young-0320/zynq-fir-decimation-ip/docs/log/48_professor_meeting_2026_07_29.md

# 48. 2026-07-29 교수님 미팅 정리 (5차)

- 작성일: 2026-07-22
- 미팅 예정일: 2026-07-29
- 목적: log38 §8 지시 4건의 완료 보고(전력 실측·ASIC 결과 중심), v1↔v2 교체 결정,
  최종 발표(8/7) 방향 확인.
- 참고 문서:
  - `docs/log/38_professor_meeting_2026_07_01.md` (§8 지시 원문)
  - `docs/log/46_power_measurement_hds242_decisions.md` §5 (전력 실측 결과)
  - `docs/log/47_asic_track_a_oasys_sweep_nitro_halt.md` (ASIC sweep·P&R 중단)
  - `docs/report/fir_n43/summary/power_board_vs_vivado.md` / `asic_vs_fpga.md`
  - `docs/report/presentation_outline.md` (발표 구성안 12장+백업)

---

## 0. 미팅 대본 / 말하기 순서

### 0-1. 시작 — 지시 4건 완료 보고

```text
지난 미팅에서 주신 지시 4건을 모두 완료했습니다.

1. ASIC 워크플로우: 학교 서버 Oasys로 v1/v2 합성 sweep을 완결했습니다.
   P&R은 서버 툴 내부 버그로 중단됐는데, 원인과 재개 절차를 문서화해 두었습니다.
2. CPU 벤치마크 PNG: CPU 스펙과 측정 방법론을 차트에 기입 완료했습니다.
3. 전력 실측: 대여해 주신 HDS242로 보드 전력을 실측했고,
   Vivado 추정과 비교분석까지 마쳤습니다. 장비는 오늘 반납드리겠습니다.
4. 통합: 위 결과를 모두 v1.0 문서에 보조 지표로 통합했습니다.

오늘은 전력 실측과 ASIC 결과 두 가지를 보고드리고,
v1/v2 중 어느 쪽을 대표 산출물로 할지 확인받고 싶습니다.
```

### 0-2. 전력 실측 결과 제시

```text
측정은 보드 5V 전원 입력에 멀티미터를 직렬로 넣어 전류를 재고,
세 가지 상태의 차분으로 변수를 분리했습니다.

  S0 (FPGA 미구성 baseline):  1.72 W
  S1 (부팅 완료, FIR idle):   2.21 W
  S2 (mode 1-1 실행 중):      2.18 W

핵심 결과 세 가지입니다.

첫째, S1 − S0 = 0.49 W가 FPGA 구성 + 145MHz 클럭 + 앱 + DDR 활성의 몫입니다.

둘째, S2가 S1과 같습니다. FIR 연산이 83µs 만에 끝나기 때문에
1~2초 데모 주기에서 평균 전력에 잡히지 않는 것이고,
"연산이 그만큼 짧고 효율적이다"라는 것 자체가 측정 결과입니다.

셋째, Vivado 추정 1.705W와의 비교입니다. 실측 2.21W에서
USB-UART 칩 몫 0.22W를 실측으로 분리하고 레귤레이터 효율 85~90%를 감안하면
1.7W 안팎으로, 추정과 정합하는 범위입니다.
```

### 0-3. ASIC 결과 제시

```text
Oasys로 v1과 v2를 같은 제약으로 20000ps부터 6000ps까지 sweep했습니다.

결과가 흥미로운데, FPGA에서 26% 차이가 났던 v1/v2가
표준셀 합성에서는 전 구간 동률입니다. 둘 다 166.7MHz 이상 통과합니다.

원인까지 확인했습니다. v1의 병목이었던 누산+라운딩 병합 경로를
FPGA CARRY4는 8.664ns에 처리했지만, 표준셀 합성기는
가산기를 재구조화해서 5.719ns에 흡수합니다.
즉 v2 분할의 이득은 FPGA의 고정 캐리 체인이라는 물리 구조에 종속된
타겟 특화 최적화라는 걸 데이터로 증명한 셈입니다.

P&R은 Nitro placer가 내부 오류(SDA101)로 두 번 같은 지점에서 죽어서
툴 버그로 결론 내리고 중단했습니다. 비교 결론은 합성 결과로 완결이라
P&R이 더해줄 것은 "post-route에서도 유지된다" 한 줄뿐이었습니다.
절차는 재개 가능하게 보존해 두었습니다.
```

### 0-4. 세게 물으실 때 짧은 답변

**mode를 돌려도 전력이 안 늘면 측정이 잘못된 것 아닌가?**

```text
아닙니다. 사전에 예상하고 문서화해 둔 결과입니다.
8192샘플 처리가 83µs라, 1~2초 데모 주기에서 duty가 0.01% 수준입니다.
멀티미터는 수백 ms 평균을 표시하므로 원리적으로 안 잡힙니다.
순간 전류 파형을 보려면 스코프+션트 구성이 필요한데,
비파괴 원칙과 범위 관리 차원에서 이번엔 제외했습니다.
```

**PL만의 전력은 분리 못 하나?**

```text
Zybo Z7-20은 코어 레일에 전류 측정 헤더가 없어서
rail 직접 측정은 트레이스 컷이 필요한 파괴적 방법입니다.
대여·실습 보드라 배제했고, 대신 상태 차분으로
"FPGA 구성+클럭이 더해지는 몫 0.49W"까지는 비파괴로 분리했습니다.
Vivado 계층 분해로는 코어 자체는 0.015W 수준입니다.
```

**250nm ASIC이 28nm FPGA보다 빠르다는 게 말이 되나?**

```text
FPGA의 로직은 LUT와 고정 배선을 거치는 오버헤드가 커서,
같은 RTL이라도 표준셀 직접 구현이 유리한 경우가 많습니다.
특히 이 설계의 병목인 캐리 체인은 FPGA에서 재구조화가 안 되는 반면
표준셀 합성은 자유롭게 최적화합니다. 그 차이가 그대로 나타난 것입니다.
```

**ASIC 전력(1.3W)이 FPGA 추정(1.7W)과 비슷한데 비교 의미는?**

```text
두 수치는 성격이 달라 절대 비교하지 않았습니다.
FPGA 1.7W는 PS7 포함 전체 칩, 코어만은 0.015W이고,
ASIC 1.3W는 250nm 공정에서 toggle-rate 가정으로 추정한 코어 값입니다.
비교 목적은 절대치가 아니라 v1↔v2의 상대 비교와 타겟 종속성 확인입니다.
```

### 0-5. v1↔v2 결정 여쭤보기

```text
마지막으로 v1과 v2 중 대표 산출물 결정을 확인받고 싶습니다.

저는 v2를 대표로 하는 게 맞다고 생각합니다.
근거는, Fmax가 116 대 146으로 26% 높고, 자원은 동급이며,
전력 차이는 6mW로 보드에서 검출 불가능한 수준이고,
145MHz 보드 기능 동작과 전력 실측까지 v2 빌드로 완료했기 때문입니다.
ASIC에서 동률이라는 결과도, v2로 가서 손해 볼 것이 없다는 뜻입니다.

v1은 버리는 게 아니라 "타겟 특화 최적화의 비교 사례"로
발표와 문서에 계속 사용합니다.
```

### 0-6. 마무리 — 남은 일정

```text
결과보고서는 7/23에 제출했고, 이제 남은 것은 8/7 최종 발표입니다.
발표는 12장 구성으로 초안을 잡아 두었고,
설계-검증-실측-보조지표 순으로 구성했습니다.
발표 분량이나 강조점에 대해 조언 주시면 반영하겠습니다.

공개 자산화(GitHub/Velog/YouTube)는 발표 전까지 순차 완료 예정입니다.
```

---

## 1. 보고 수치 요약

### 전력 실측 (Track B, 2026-07-22)

| 상태 | 조건 | I_med | V | P |
| --- | --- | ---: | ---: | ---: |
| S0 | PL 미구성 baseline | 0.340 A | 5.047 V | 1.72 W |
| S1 | boot 완료, FIR idle | 0.443 A | 4.988 V | 2.21 W |
| S2 | `mode 1-1` 반복 실행 | 0.435 A | 5.008 V | 2.18 W |

- S1−S0 = 0.49W (PL 구성+클럭+앱+DDR), S2−S1 ≈ 0 (µs burst 미검출 — 예측 부합)
- USB-UART 0.22W 실측 분리, Vivado 1.705W와 정합 범위
- 부가: reset 없는 `mode 1-1` 반복 실행 정상 (§5.1 한계 "정상 경로 해소" 보드 확정)

### ASIC (Track A, log 47)

| | FPGA (28nm) | ASIC (250nm 합성) |
| --- | ---: | ---: |
| v1 Fmax | 116 MHz | ≥ 166.7 MHz |
| v2 Fmax | 146 MHz | ≥ 166.7 MHz |
| v1↔v2 격차 | +26% | 노이즈 수준 (동률) |

- 같은 병목 경로: CARRY4 8.664ns vs 표준셀 5.719ns → 분할 이득은 FPGA 물리 구조 종속
- Nitro P&R: placer 내부 버그(SDA101) 2회 재현으로 중단, 절차 보존

## 2. 지난 지시(log38 §8) 반영 현황

| 지시 | 상태 | 산출물 |
| --- | :--: | --- |
| §8-1 ASIC 워크플로우 | ✅ | log 47, `summary/asic_vs_fpga.md` (합성 완결, P&R 중단 문서화) |
| §8-2 CPU PNG 측정조건 명시 | ✅ | `cpu_vs_fpga_timing_window.png` 스펙·방법론 기입 |
| §8-3 전력 실측 | ✅ | log 46 §5, `summary/power_board_vs_vivado.md` |
| §8-4.5 v1.0 문서 통합 | ✅ | sweep_summary 교차참조, 보고서·발표 초안 반영 (D2) |

## 3. v1↔v2 결정 논의 자료

| 판단 축 | v1 | v2 | 비고 |
| --- | --- | --- | --- |
| FPGA Fmax | 116 MHz | **146 MHz (+26%)** | clk_wiz 정밀 스윕 (log 40) |
| 자원 | 동급 | 동급 (LUT 1792/FF 2113/DSP 16) | 파이프 FF 소폭 차이뿐 |
| Vivado 전력 | 1.699 W | 1.705 W | Δ6mW — 보드 검출 불가 (log 46 §2) |
| 보드 검증 | 115MHz 기능 동작 ✅ | 145MHz 기능 동작 + 전력 실측 ✅ | 실측 이력은 v2가 더 두터움 |
| ASIC | 동률 | 동률 | 교체해도 ASIC 관점 손실 없음 |

**제안: v2를 대표 산출물로 채택.** v1은 폐기가 아니라 "타겟 특화 최적화 비교 사례"
(발표 슬라이드 9·11의 주인공)로 유지.

## 4. 실제 미팅 피드백 (2026-07-29)

별도의 수정 지시나 방향 변경 없이 종료되었다. 준비한 발표자료(PPT)를 검토하시고
잘 준비했다는 평을 주신 것이 피드백의 전부다.

정리:

- 추가 지시사항 없음. §0 대본으로 준비한 전력·ASIC 보고와 예상 질문 답변은 실제로
  깊게 파고드는 질의 없이 지나갔다.
- v1↔v2 대표 산출물은 §3의 제안대로 **v2**로 확정. 이후 발표자료·배포 이미지
  (`release/v2_145mhz/BOOT.bin`)·전력 실측 기준이 모두 v2@145MHz로 통일되어 있다.
- HDS242 반납 완료.
- 남은 일정은 8/7 최종 발표뿐이며, 공개 자산화(GitHub·Velog)는 자체 일정으로 진행.

즉 이 미팅은 방향을 바꾸는 자리가 아니라 앞선 4차 미팅 지시사항(보조지표 4건)의
이행을 확인하고 발표 준비 상태를 점검하는 자리였다.
