young-0320/zynq-fir-decimation-ip/asic/oasys/results/sweep_report.md

# ASIC(Oasys) Synthesis Frequency Sweep — FIR v1/v2

- 대상: `fir_n43`(v1) / `fir_n43_v2`(v2) — 순수 FIR core, 단일 파일 (`rtl/transposed_form/n43/`)
- 합성 도구: Oasys-RTL, 공정: Tanner Generic 250nm (`TANNER_TT_2P50V_25C.lib`, TT/2.5V/25°C)
- 방법론: `asic/oasys/clk.sdc` 하나를 v1/v2가 공유 — 같은 period로 페어 실행한 결과만 비교표에 올린다
- 목적: workflow_v23 Track A(§8-1) ASIC 보조 지표 + "v1의 critical path 병목(FPGA CARRY4
  캐리 체인)은 FPGA 전용"이라는 가설 실증
- 작성일: 2026-07-21 (sweep 진행에 따라 갱신)

## 1. Sweep 결과 — v1 (`fir_n43`)

margin(%) = WNS / period × 100.

| period(ps) | freq(MHz) | WNS(ps) | margin(%) | cells | area(sq um) | total_power(mW) | result |
| ---: | ---: | ---: | ---: | ---: | ---: | ---: | --- |
| 20000 | 50.0 | +1757.5 | 8.8 | 16918 | 1115360 | 689.0 | pass |
| 15000 | 66.7 | +946.6 | 6.3 | 25193 | 1333340 | 794.0 | pass |
| 12000 | 83.3 | +1133.5 | 9.4 | 25387 | 1337280 | 843.0 | pass |
| 10000 | 100.0 | +199.0 | 2.0 | 25994 | 1354345 | 944.4 | pass |
| 9000 | 111.1 | +100.2 | 1.1 | 26018 | 1353851 | 987.3 | pass |
| 8000 | 125.0 | +52.0 | 0.7 | 27359 | 1390189 | 1115.0 | pass |
| 6000 | 166.7 | +0.3 | 0.0 | 28615 | 1421329 | 1330.9 | pass |

## 2. Sweep 결과 — v2 (`fir_n43_v2`)

| period(ps) | freq(MHz) | WNS(ps) | margin(%) | cells | area(sq um) | total_power(mW) | result |
| ---: | ---: | ---: | ---: | ---: | ---: | ---: | --- |
| 20000 | 50.0 | +2039.1 | 10.2 | 16799 | 1122327 | 682.3 | pass |
| 15000 | 66.7 | +4680.8 | 31.2 | 25118 | 1344378 | 781.1 | pass |
| 12000 | 83.3 | +1680.8 | 14.0 | 25118 | 1344378 | 847.5 | pass |
| 10000 | 100.0 | +129.2 | 1.3 | 25689 | 1360577 | 954.4 | pass |
| 9000 | 111.1 | +526.3 | 5.8 | 25718 | 1360446 | 995.6 | pass |
| 8000 | 125.0 | +72.3 | 0.9 | 27002 | 1394726 | 1119.4 | pass |
| 6000 | 166.7 | +13.5 | 0.2 | 27506 | 1405196 | 1342.4 | pass |

(주1) power는 `report_power -total_only`로 추출 — 한 줄에 internal/switching/leakage/total
분해가 모두 포함된다(PF-263). 기본 `report_power`는 계층 없는 코어 직접 합성이라 인스턴스
4096개에서 잘리며 total이 생략되므로 쓰지 않는다. 이 power는 워크로드 VCD가 아닌 기본
toggle-rate 가정 기반 추정치.

## 3. v1 vs v2 비교 (동일 period 페어)

| period(ps) | v1 WNS | v2 WNS | ΔWNS(v2−v1) | v1 area | v2 area | Δarea | v1 P(mW) | v2 P(mW) | ΔP |
| ---: | ---: | ---: | ---: | ---: | ---: | ---: | ---: | ---: | ---: |
| 20000 | +1757.5 | +2039.1 | +281.6 | 1115360 | 1122327 | +0.6% | 689.0 | 682.3 | −1.0% |
| 15000 | +946.6 | +4680.8 | +3734.2 | 1333340 | 1344378 | +0.8% | 794.0 | 781.1 | −1.6% |
| 12000 | +1133.5 | +1680.8 | +547.3 | 1337280 | 1344378 | +0.5% | 843.0 | 847.5 | +0.5% |
| 10000 | +199.0 | +129.2 | −69.8 | 1354345 | 1360577 | +0.5% | 944.4 | 954.4 | +1.1% |
| 9000 | +100.2 | +526.3 | +426.1 | 1353851 | 1360446 | +0.5% | 987.3 | 995.6 | +0.8% |
| 8000 | +52.0 | +72.3 | +20.3 | 1390189 | 1394726 | +0.3% | 1115.0 | 1119.4 | +0.4% |
| 6000 | +0.3 | +13.5 | +13.2 | 1421329 | 1405196 | −1.1% | 1330.9 | 1342.4 | +0.9% |

### Critical path 구조 (핵심 관찰)

| | startpoint | endpoint | logic depth | 경로 구조 |
| --- | --- | --- | ---: | --- |
| v1 @20000ps | `prod_reg_reg[10][1]/Q` | `z_reg[32][47]/DATA` | 85 | Stage2 가산기 (prod_reg + z → z_reg), AOI22/BUFI4 반복 = ripple-carry 체인 |
| v2 @20000ps | `prod_reg_reg[8][1]/Q` | `z_reg[34][47]/DATA` | 84 | 동일 구조 |
| v1 @15000ps | `prod_reg_reg[10][1]/Q` | `round_reg_reg[32]/DATA` | 50 | 누산+라운딩 병합 경로 — v2가 분할한 바로 그 경로 (탭 가산기는 재구조화로 빨라져 depth 85→50, 대신 이 병합 경로가 병목으로 부상) |
| v2 @15000ps | `in_sample[3]` (input port) | `prod_reg_reg[23][26]/DATA` | 48 | 입력→곱셈 경로 (미제약 입력, rtDefaultClock). worst가 이 경로라는 것 = 내부 reg-to-reg 전부 slack ≥ +4680.8 |
| v1 @12000ps | `prod_reg_reg[10][1]/Q` | `round_reg_reg[31]/DATA` | 40 | 여전히 누산+라운딩 병합 경로. 합성기가 더 조여서 depth 50→40, slack은 15000ps 때보다 오히려 개선(+946.6→+1133.5) |
| v2 @12000ps | `in_sample[3]` | `prod_reg_reg[23][26]/DATA` | 48 | 15000ps와 동일 netlist (cells/area/arrival 10038.9ps 완전 동일 — 여유가 있어 재합성 불필요). 한계는 입력→곱셈 경로 ~10039ps |
| v1 @10000ps | `prod_reg_reg[0][6]/Q` | `round_reg_reg[30]/DATA` | 40 | 병합 경로가 arrival 9520.7ps까지 압축 — 12000ps 때 "하한"으로 보였던 곱셈 경로(10039ps)보다도 빨라짐 (곱셈 경로도 재구조화됨) |
| v2 @10000ps | `z_reg[0][47]/Q` | `round_reg_reg[32]/DATA` | 33 | v2 자신의 라운딩 스테이지(Stage3, z[0]→round_reg)가 병목으로 등장, arrival 9590.5ps — v1의 병합 경로와 사실상 같은 수준 |
| v1 @9000ps | `prod_reg_reg[0][5]/Q` | `round_reg_reg[29]/DATA` | 39 | 병합 경로 8619.5ps까지 추가 압축 (−9.5%) — 아직 한계 아님 |
| v2 @9000ps | `in_sample[1]` | `prod_reg_reg[13][24]/DATA` | 38 | 라운딩 스테이지가 재구조화로 물러나고 입력→곱셈 경로가 다시 worst (10038.9→8193.4ps, −18%) |
| v1 @8000ps | `prod_reg_reg[0][4]/Q` | `round_reg_reg[31]/DATA` | 38 | 병합 경로 7667.7ps (−11%) — 여전히 압축 여력 발견 |
| v2 @8000ps | `z_reg[0][47]/Q` | `round_reg_reg[32]/DATA` | 24 | 라운딩 스테이지 복귀, 7647.4ps — v1과 20ps 차이 |
| v1 @6000ps | `z_reg[1][8]/Q` | `round_reg_reg[31]/DATA` | 31 | FPGA v1 critical path와 시작·끝이 동일한 경로(z_reg[1]→round_reg, log 39의 z_reg[1][2]→round_reg_reg[45]) — 단 도달치 5718.7ps로 slack +0.3, 턱걸이 PASS |
| v2 @6000ps | `in_sample[4]` | `prod_reg_reg[24][25]/DATA` | 26 | 입력→곱셈 경로 5706.2ps |

## 4. 해석 (sweep 진행하며 갱신)

**20000ps (느슨한 제약) — 잠정 "v1 ≈ v2"로 보였던 구간:**

- 두 버전 모두 critical path가 순수 탭 누산 경로(prod_reg[k]+z[k+1]→z_reg[k])의
  ripple-carry 체인(depth 85). 느슨한 제약에서 합성기가 면적 최소인 ripple 매핑을
  선택해 add 1회 자체가 지배적이었고, v2가 분할한 누산+라운딩 병합 경로는 한계를
  정하는 경로가 아니었다 → WNS 차이 1.4%p로 "분할은 FPGA 전용" 가설과 일치해 보임.

**15000ps (타이트한 제약) — 반전, 분할이 ASIC에서도 유효:**

- 제약을 조이자 합성기가 탭 가산기를 더 빠른 구조로 재합성(depth 85→50, 그 대가로
  cells +49%/area +19%). 그러자 v1의 병목이 누산+라운딩 병합 경로
  (prod_reg→round_reg)로 이동 — FPGA에서와 같은, v2가 분할한 바로 그 경로다.
- v2는 그 경로가 없어 WNS +4680.8 vs v1 +946.6 — slack 5배 차이. v2의 worst 경로는
  미제약 입력 경로(in_sample→prod_reg)라서 내부 reg-to-reg 한계는 이보다도 위에 있다.
- 잠정 Fmax 추정(1/(period−WNS)): v1 ≈ 71MHz, v2 ≥ 97MHz — 파이프라인 분할이
  ASIC에서도 유효하다는 방향. "분할은 FPGA 전용 최적화" 가설은 느슨한 제약에서만
  성립하는 착시였고, 도구가 가산기를 최적화하고 나면 타겟 불문 "add+round 병합"이
  구조적 병목이라는 쪽으로 수렴 중. 확정은 pass/fail 경계(이분탐색)로.
- 전력·면적은 여전히 v1 ≈ v2 (ΔP −1.6%, Δarea +0.8%): 분할의 비용이 사실상 0이라는
  점도 v2의 손을 들어줌. leakage는 total의 0.001% — 250nm 예상대로 무시 가능,
  "ASIC total ≈ dynamic" 취급 유효.

**12000ps — 격차는 좁혀지나 순서는 유지, 공통 하한(곱셈 경로) 등장:**

- v1: 합성기가 라운딩 병합 경로를 더 조여(depth 50→40, cells +194) slack이 15000ps보다
  오히려 개선(+1133.5). v2: 15000ps netlist 그대로 재사용(여유 충분) — 한계는 입력→곱셈
  경로 arrival ~10039ps로 고정.
- 잠정 Fmax 추정: v1 ≈ 92MHz, v2 ≈ 97MHz — 15000ps에서 5배였던 slack 격차가 좁혀짐.
  ~~곱셈 경로 ~10ns가 공통 하한~~ → 10000ps에서 곱셈 경로도 재구조화되어 하한이
  아니었음이 확인됨(아래).

**10000ps — 수렴: 둘 다 PASS(100MHz), v1이 근소 우위로 역전:**

- v1 +199.0 vs v2 +129.2 (ΔWNS −69.8ps, period의 0.7%) — 12000ps까지의 v2 우위가
  사라지고 사실상 동률(오히려 v1이 근소 우위).
- 메커니즘: 합성기를 한계까지 밀자 v1의 누산+라운딩 병합 경로가 9520.7ps까지 압축됨
  (multi-operand add를 carry-save/compound 구조로 재조직 — 표준셀에서는 add 2회
  병합이 add 1회 + 압축단 수준의 비용). 한편 v2는 자신의 라운딩 스테이지(z[0]→
  round_reg, 48-bit 라운딩 가산)가 새 병목으로 등장, 9590.5ps — 결국 양쪽 다
  "라운딩이 포함된 최종 가산" 하나가 한계를 정하는 동일 구도로 수렴.
- 이것이 FPGA와의 구조적 차이: FPGA CARRY4는 고정 캐리 체인이라 add 2회 병합을
  재구조화할 수 없어 v1의 병합 경로가 통째로 두 체인 값을 냈고(그래서 분할이 26%
  이득), ASIC 표준셀 합성은 그 병합을 흡수해버린다 — "분할의 이득은 FPGA 물리
  구조에 종속" 가설이 pass/fail 경계 근처에서 결국 성립하는 방향.
- 잠정 Fmax 추정: v1 ≈ 102MHz, v2 ≈ 101MHz. ~~8000ps는 확실한 FAIL~~ →
  9000ps 결과로 반증됨(아래) — 합성기의 스텝당 개선(~10%)이 아직 포화되지 않았다.

**9000ps — 둘 다 PASS(111MHz), v2 재역전, 순위는 런마다 요동:**

- v1 +100.2(margin 1.1%) vs v2 +526.3(5.8%) — 10000ps에서 뒤졌던 v2가 다시 앞섬.
  v2는 라운딩 스테이지가 재구조화로 물러나고 입력→곱셈 경로가 worst로 복귀
  (8193.4ps, 12000ps 대비 −18%). v1 병합 경로도 8619.5ps로 −9.5% 추가 압축.
- 순위가 런마다 뒤집히는 것 자체가 결론의 일부: 두 버전의 한계 경로 도달치가 수 %
  이내로 붙어 있어, 순서는 합성 휴리스틱의 런별 편차에 좌우된다. FPGA의 26% 차이
  같은 구조적 격차는 ASIC에 없다.
- 잠정 Fmax 추정: v1 ≈ 112MHz, v2 ≈ 118MHz. 다음: 8000ps 페어 — v1은 −10.4% 추가
  압축이 필요해 경계 직전(직전 스텝 개선폭 −9.5%와 거의 같음), v2는 −5.8%면 됨.
  여기서 v1 FAIL / v2 PASS로 갈리면 그 지점이 최종 판별점.

**8000ps — 판별점에서도 안 갈림: 둘 다 PASS(125MHz), Δ 20ps로 완전 수렴:**

- v1 +52.0 vs v2 +72.3 — 차이 20.3ps는 period의 0.25%. v1 병합 경로 7667.7ps,
  v2 라운딩 스테이지 7647.4ps로 도달치까지 사실상 동일. "v1 FAIL/v2 PASS로 갈린다"는
  시나리오는 실현되지 않음 — v1의 병합 경로는 8000ps에서도 압축 여력을 찾아냄.
- margin 추이(2.0→1.1→0.7%)와 면적 증가(cells 25994→27359)를 보면 툴이 "겨우 맞추기"
  를 반복하며 한계에 접근 중. 잠정 Fmax: v1 ≈ 125.8MHz, v2 ≈ 126.1MHz — 격차 0.3%.
- 결론 방향 사실상 확정: ASIC(현대적 datapath 합성)에서는 v1/v2 구조적 격차가 없다.
  v2 분할의 이득은 FPGA CARRY4 고정 체인에서만 발생하는 타겟 특화 효과.
- 다음: 아직 FAIL 앵커가 없음 — ~~7000ps~~ → 6000ps로 직행하기로 결정.

**6000ps — 여전히 둘 다 PASS(166.7MHz, v1은 slack +0.3ps 턱걸이). sweep 중단 결정:**

- −25% 압축 요구도 툴이 맞춰냄: v1 5718.7ps(slack +0.3), v2 5706.2ps(+13.5). Δslack
  13.2ps — 여전히 노이즈 수준 동률. 250nm ASIC이 28nm FPGA v2의 146MHz를 넘는
  166.7MHz에 도달했다는 것도 부수 확인.
- v1의 critical path가 FPGA v1과 시작·끝이 동일한 경로(z_reg[1]→round_reg)로 회귀 —
  같은 경로를 FPGA CARRY4는 8.66ns(120MHz fail, log 39), 250nm 표준셀 재구조화는
  5.72ns에 처리. "툴이 병합을 흡수한다"의 가장 직접적인 대비 증거.
- 방법론적 교훈(중단 사유): margin이 매 지점 0으로 수렴하는 건 한계 신호가 아니라
  제약 구동 합성의 본성이다 — 툴은 목표를 주면 면적을 태워 "겨우 맞추기"를
  반복하므로(cells 25994→28615), pass/fail 경계 탐색은 진짜 물리 한계가 나올 때까지
  런당 수 시간짜리 시도를 계속 요구한다. 절대 Fmax 확정은 Track A 목적(보조 지표 +
  v1/v2 비교)에 불필요하므로 여기서 중단, "양쪽 모두 ≥166.7MHz 확인(한계 미탐색),
  전 구간 격차 노이즈 수준"을 최종 기록으로 채택.

**최종 결론 (sweep 종료):**

- 20000→6000ps 6개 페어 전 구간에서 v1/v2 격차는 최대 수 %·순위 요동 — ASIC(현대적
  datapath 합성)에서 v1/v2 구조적 격차 없음. v2 분할의 26% Fmax 이득은 FPGA CARRY4
  고정 캐리 체인에서만 발생하는 타겟 특화 효과로 확정.
- 면적·전력도 전 구간 Δ 1% 안팎 동률. 주파수에 따라 면적 +27%(1.12M→1.42M),
  전력 689→1331mW로 증가 — 제약을 조일수록 툴이 면적/전력을 태워 타이밍을 사는
  전형적 trade-off (GEMM sweep과 동일 패턴).

## 5. FPGA 대비

작성 완료 — `docs/report/fir_n43/summary/asic_vs_fpga.md` (핵심 표 + 비교 한계 명시).

## 6. 남은 작업 / 이슈

- [x] ~~power total 재추출~~ — 20000ps 페어 `-total_only`로 재추출 완료. `-total_only`
      한 줄에 internal/switching/leakage 분해까지 포함되므로(PF-263) 이후 sweep도 이
      명령만 쓰면 됨 (`-all` grep 불필요).
- [x] ~~sweep~~ — 6페어(20000→6000ps) 완료, 전 지점 pass, §4 최종 결론으로 종료.
- [x] ~~FPGA 대비~~ — §5 참조.
- [x] ~~Nitro P&R (10000ps v1)~~ — 중단 (2026-07-21). 시도 기록: ① datapath 블럭
      36개가 고정 객체로 칩 밖에 생성됨 — 미배치 시 routing 실패, `place_macros`는
      "movable macro 없음"(PLC1020)으로 거부 → 수동 배치 필요(GEMM 수업 방식과 동일).
      ② 수동 배치 후 `run_place_timing`이 placer 내부 assertion 크래시
      (`SDA101: grCapFrac <= 1`, densityboxcontrol.cpp) — 칩 1.4mm(util 70%)→1.6mm
      (util 53%) 확대·재배치 후에도 동일 지점에서 재현. 2020.2 툴 내부 버그로 판단,
      사용자 측 회피 불가로 결론. 판정 근거 4가지(assertion 성격, 파라미터 무관 재현,
      GEMM 대조군, 회피 수단 소진)와 에러 원문은 `asic/nitro/error_records.md`.
      비교 결론은 합성(Oasys) 결과로 완결이므로 P&R은 범위에서 제외 —
      절차·스크립트(`asic/nitro/tcl/`)는 재개 가능 상태로 보존.

## Raw 리포트 경로

```text
asic/oasys/results/v1/v1_<period>ps_{synth.v,timing.rpt,area.rpt,power.rpt}
asic/oasys/results/v2/v2_<period>ps_{synth.v,timing.rpt,area.rpt,power.rpt}
```
