young-0320/zynq-fir-decimation-ip/docs/workflow/workflow_v24.md

# workflow_v24 — 마무리·공개 체크리스트 (최종)

- 작성일: 2026-07-22
- Purpose: 기술 작업(workflow_v23까지 전부 완료) 이후 남은 **제출·발표·공개 자산화**
  작업을 기한 순 체크리스트로 관리한다. 이 문서가 마지막 워크플로우다.
- 성격: 실행 계획/준비물 (결과·의사결정은 해당 log에 기록 — log 48 §4, 이후 필요 시 log 49)
- 선행: `workflow_v23.md` (Track A/B/C/D ✅), `docs/log/48` (5차 미팅 자료)
- 갱신: 2026-08-16 — §7 발표 수행 완료, §6 YouTube는 제작하지 않기로 확정(취소).
  §1~§5는 이전 갱신(2026-08-06)대로 완료. 남은 것은 §8 종료 처리뿐이다.

---

## 0. 타임라인 요약

| 기한 | 항목 | 섹션 |
| --- | --- | --- |
| **7/23 (목)** | 결과보고서 제출 | §1 |
| **7/29 (화)** | 5차 지도미팅 + HDS242 반납 + v1↔v2 결정 | §2 |
| ~8/6 | 발표자료 완성 + 리허설, 데모 준비 완료 | §3, §7 |
| **8/7 (목)**  | 최종 발표 | §7 |
| ~8/7 | GitHub·Velog 공개 자산화 완료 (YouTube는 취소) | §4~§6  |

---

## 1. 결과보고서 제출 (기한: 7/23 목) ✅ 완료 (2026-07-23 제출)

- [X] Ⅰ. 도전결과 및 성과 삽입 — 실측 완료 버전으로 교체
- [X] Ⅵ 총평: "초안 작성해보았습니다" 문구 삭제
- [X] Ⅵ 총평: "두 가지임"으로 수정 (첫째·둘째 구성과 정합)
- [X] Ⅱ 요약문 절감/초과 서술 모순 수정
- [X] Ⅱ 표 아래 예비비 공용 각주 추가
- [X] Ⅲ 중복 잔여 문장 삭제
- [X] Ⅲ 4-2 제목 → "시연 시각화 강화 지도"
- [X] Ⅲ 이메일 5/13 주제 → "피드백 반영·구매 상담"
- [X] 표지 지도교수 전화번호 확인 (031-201-3811)
- [X] 서식 확인
- [X] 교수님 Ⅵ 총평 검토·서명(인) — 2026-07-22자
- [X] 최종 PDF 변환 → 제출
- [X] 문서화 변경분 git 커밋

## 2. 5차 지도미팅 (7/29 화) — 진행 완료

- [X] `docs/log/48` §0 대본 숙지
- [X] **HDS242 반납**
- [X] **v1↔v2 대표 산출물 결정** — v2 채택 (발표자료·배포 이미지 모두 v2@145 기준)
- [X] 발표 분량·강조점 조언 받기
- [X] 미팅 결과를 log 48 §4에 기록 (2026-08-06) — 추가 지시 없이 발표 준비 상태 점검으로
  종료. v2 확정, HDS242 반납 완료

## 3. 데모 준비 (발표 시연용, ~8/6) ✅ 완료

- [X] **v2@145 BOOT SD 준비** (배포본은 `release/v2_145mhz/BOOT.bin`로도 추적 중)
- [X] 예비 SD 1장
- [X] 데모 노트북(Windows) 환경 점검
- [X] 전원 구성 확정
- [X] 데모 리허설
- [X] 실패 대비: FFT plot PNG 사전 캡처본을 백업 슬라이드에 포함

## 4. GitHub 정리 (~8/7, 에이전트 초안 지원 가능)

공개 전 문서 톤 정리는 **계층화 전략**으로 (전면 재작성 안 함 — 2026-07-22 확정):

- Tier 1 (관문 문서만 톤 정리): README + `summary/` 4종(scenario1_1/1_2,
  asic_vs_fpga, power_board_vs_vivado) — 이모지·과한 볼드·메타 표현 제거, 수치 불변
- Tier 2 (원본 보존 + 프레이밍): `docs/log/`·`docs/workflow/`는 가공하지 않고,
  `docs/log/README.md`에 "AI 협업 워크플로우로 작성된 의사결정 로그 원본, 사후 가공
  없이 보존" 안내문 한 장 추가
- Tier 3 (본인 목소리): Velog 연재는 에이전트 초안 후 **본인 퇴고 필수**

- [X] Tier 1 톤 정리 — summary 4종 + sweep_summary/_v2 + sweep_report + build_artifacts (2026-07-22)
- [X] Tier 2 — `docs/log/README.md`·`docs/workflow/README.md` 프레이밍 안내문 (2026-07-22)
- [X] README 재작성(소개·결과·차별점 중심) + `docs/getting_started.md` 분리 (2026-07-22).
  헤드라인 수치 5개는 배치 원칙의 예외로 README에 허용(사용자 확정)
- [X] 재현 절차 점검 (2026-07-23 전수조사 C) — 시뮬 경로는 성립: pytest 163개 PASS,
  벡터 삭제 후 문서 명령만으로 비트 단위 동일 재생성, `run_all`/`run_bug` 전부 PASS.
  발견된 결함은 아래 "전수조사 후속" 항목으로 이관
- [X] 민감 정보 스캔 (2026-07-22) — 학번·전화번호 텍스트 마스킹 완료. hwp·장학 md의
  잔여분과 히스토리 퍼지는 보류(사용자 판단: 민감도 낮음, 시간 나면 처리)
  → 2026-07-23 재스캔 결과 반영: asic tcl 학번 경로·author 이메일·교수 전화번호는
  **그대로 두기로 확정**(사용자 결정). 시크릿·10MB 초과 추적 파일 없음
- [X] 라이선스 파일 — 루트 LICENSE(MIT, 본인 명의) 존재 확인 (2026-07-22)
- [X] repo public 전환 → **링크 확보** (2026-08-06) —
  https://github.com/young-0320/zynq-fir-decimation-ip

### 전수조사 후속 (2026-07-23 감사 결과, public 전환 전 처리)

- [X] 🔴 **장학·제출 서류 삭제** (2026-08-06) — `docs/경희꿈도전장학 활동계획서_한영웅.pdf`,
  `docs/팀명_결과보고서.hwp`, 초안 md 2종(`final_report_draft.md`,
  `scholarship_report_section1_and_fixes.md`), `presentation_outline.md` 모두 레포에서
  제외. git 히스토리 퍼지는 하지 않음(민감도 낮음 — 2026-07-23 판단 유지)
- [X] 🔴 **fresh clone `make run_all` 실패 해소 (2026-07-23)** — README 수정 대신
  Makefile 자동 생성으로 해결(사용자 선택): `run_all`/`run_legacy_n5`가 벡터 부재 시
  기존 Python 스크립트 2종을 자동 실행(있으면 불변). 벡터 삭제 후 재검증 —
  자동 생성 → 전 TB PASS, 재생성 벡터 비트 동일. README Quick Start는 수정 불필요
- [X] README 개선 (2026-07-23) — 한/영 병기 전문 재작성: 이미지 3종(BD SVG·scenario1_1
  FFT·CPU 차트, 한글 본문에만 삽입/영어는 상단 그림 참조), Requirements, 근거 링크
  불릿화, Repository Map에 `boards/`·`release/` 추가+`build/` 각주, License(MIT) 섹션
- [X] **BOOT.bin 정식 승격 (2026-07-23)** — `release/v2_145mhz/BOOT.bin`(기본 권장)·
  `release/v1_115mhz/BOOT.bin` git 추적 + `release/README.md` 사용법. `.gitignore`
  `!release/*/BOOT.bin` negation. 클론 직후 빌드 없이 보드 데모 가능.
  경위: `docs/log/50`
- [X] (참고) n5 벡터 재생성 절차 (2026-07-23) — 문서화 대신 Makefile 자동 생성으로
  해소 (`run_legacy_n5`가 n5 벡터 부재 시 자동 생성, 위 항목과 동일 패턴)
- [ ] (참고) axis TB 2종의 `$readmemh` "Too many words [0:4095]" 경고 (4117워드 vs 4096
  배열) — 판정 무해하나 첫 사용자 불안 요소

## 5. Velog 연재 ✅ 완료 (2026-08-06, 요구 3편 이상 → 5편 게시)

실제 연재는 후보 주제 나열이 아니라 **시간순 서사**로 재구성했다. 트러블슈팅 3편
(2·3·4편)을 중심에 두되, 앞에 bring-up(1편)을, 뒤에 결산(5편)을 붙여 프로젝트 전체가
하나의 흐름으로 읽히게 했다. ASIC 타겟 종속성은 독립 편 대신 5편의 핵심 절로 넣었다.

- [X] 1편: Block Design부터 비트스트림·XSA까지
- [X] 2편: DDR byte[3] 오염 — JTAG ELF 로딩에 걸린 16일 (재료: log 21~27)
- [X] 3편: 끝나지 않는 MM2S — AXI DMA 1바이트 초과 (재료: log 31/32)
- [X] 4편: 동작하는 회로의 버그 4개 (재료: log 41~44)
- [X] 5편: 숫자로 쓰는 결산 — Fmax 스윕·CPU 대비·전력 실측·ASIC 교차 검증
  (재료: log 37/39/40/46/47/49 + summary 4종)
- [X] 링크 확보 → README 한/영 "개발 연재 (Velog)" 섹션에 5편 전부 반영

5편 작성 중 확인된 사항 (원고에 반영, 근거는 아래 문서):

- N=43 선정 근거를 저지대역 worst-case 기준으로 재서술 (log 07 — 39/41탭은 25MHz
  한 점만 보면 통과처럼 보이나 전 구간 worst-case에서 미달)
- 시나리오 1-2의 45MHz 실측 −64.5dB는 필터 성능이 아니라 **측정계의 관측 하한**
  (계수 응답 |H(45MHz)| = 77.2dB, float64 재현에서도 동일 수준 → 양자화 아님)
- 25MHz만 −6.02dB 정규화 오프셋이 상쇄됨 (출력 Nyquist bin은 크기가 2배로 잡힘)
- CPU 221.0µs는 대표값이 아니라 최종 차트 생성 라운드의 값이며 관찰 구간(170~300µs)의
  높은 쪽 — 배속을 2.0~3.5배 구간으로 병기 (log 49)

## 6. YouTube 데모 영상 — ❌ 제작하지 않음 (2026-08-16 확정)

2026-08-06 시점에는 "발표 후로 연기"였으나, 발표를 마친 뒤 **제작하지 않는 것으로
확정**했다. 발표 당일 라이브 데모가 성립했고, 시연 근거는 백업 캡처본(§3)과 레포의
FFT plot·측정 리포트로 이미 남아 있어 영상이 추가로 확보하는 것이 없다.

공개 자산은 **GitHub·Velog 2종**으로 확정한다 (발표 마지막 슬라이드도 동일).

아래는 취소된 계획으로, 기록 목적으로만 남긴다.

- ~~촬영 구성안: 보드·결선 소개(30초) → SD boot + `READY FIR`(30초) →
  `mode 1-1` 실행 + FFT plot(1분) → 입·출력 스펙트럼 비교 해설(1분) — 총 3분 내외~~
- ~~촬영 (화면 녹화 + 보드 실물 컷, 폰 거치 고정)~~
- ~~자막/설명란: 프로젝트 요약 + GitHub 링크~~
- ~~업로드 → 링크 확보 → README "개발 연재" 섹션에 추가~~

## 7. 최종 발표자료 + 발표 (8/7 목) ✅ 완료

- [X] 슬라이드 제작 — 본문 7장 + 백업 3장 구성으로 확정 (outline 12장안 대비 압축)
- [X] 그림 자산 수집: BD 블록도, FFT plot, `cpu_vs_fpga_timing.png`, 전력 측정표, ASIC 표
- [X] 백업 슬라이드 (전력 실측 · 구현 수치 요약 · 보드 검증 수치) + Q&A 답변 숙지
- [X] 5차 미팅 조언 반영
- [X] 리허설
- [X] 마지막 슬라이드에 공개 자산 링크 2종 (GitHub/Velog)
- [X] 발표 당일 준비물: 노트북, 보드, SD 2장, 어댑터, USB 케이블, 발표자료 USB/클라우드 백업
- [X] **8/7 발표 수행**

## 8. 종료 처리

- [X] 발표 후 피드백·결과 기록 — **해당 없음, log 51 생성 안 함**. 질의응답이나 피드백
  없이 발표만 진행된 자리였다. 기록할 내용이 없어 이 줄로 대체한다
- [X] 대여물 반납 완료 확인 (HDS242 — §2, 7/29 미팅에서 반납)
- [X] CLAUDE.md 갱신 — 2026-08-06 공개 자산화 반영 후, 2026-08-16 발표 완료·YouTube
  취소로 완결 표시까지 반영
- [X] 최종 커밋 (2026-08-16, 발표 완료·YouTube 취소 문서 현행화)
- [X] ~~`v1.0` tag~~ — **달지 않기로 확정** (2026-08-16). 태그 없이 종료한다
- [X] ~~YouTube 영상 (§6)~~ — 제작하지 않기로 확정 (2026-08-16), README 반영 불필요

---

## 현재 상태 (2026-08-16)

| 절 | 상태 |
| --- | --- |
| §1 결과보고서 | ✅ 7/23 제출 |
| §2 5차 미팅 | ✅ 7/29, 결과 log 48 §4 기록 완료 |
| §3 데모 준비 | ✅ |
| §4 GitHub | ✅ public 전환 완료 — https://github.com/young-0320/zynq-fir-decimation-ip |
| §5 Velog | ✅ 5편 게시 (요구 3편 이상) |
| §6 YouTube | ❌ 제작하지 않음 (2026-08-16 확정) |
| §7 발표 | ✅ 8/7 발표 수행 완료 |
| §8 종료 | ✅ 완료 — log 51·`v1.0` tag 모두 미생성으로 확정 |

**프로젝트 종료.** 계획된 작업은 전부 끝났다.

유일한 미결은 §4의 참고 항목 하나 — axis TB 2종의 `$readmemh` "Too many words"
경고다. 판정에는 무해하고(전 TB PASS) 고치지 않은 채 종료한다. 처리하려면 TB의
배열 크기를 4096 → 4117로 맞추면 되나, 이는 검증 결과를 바꾸지 않는 미화 작업이다.

---

## 에이전트 지원 가능 항목 요약

| 항목 | 에이전트가 할 수 있는 것 |
| --- | --- |
| §1 보고서 | 수정 문안은 전부 준비됨 (대화 기록) — 반영은 사용자(한글 파일) |
| §4 GitHub | README·재현 절차 초안 작성, 민감 정보 스캔 |
| §5 Velog | 각 편 초안 작성 (log 재료 기반) |
| §7 발표자료 | 슬라이드별 문안·표·그림 스펙 작성, Q&A 답변 정리 |
| §8 종료 | log 49 정리, CLAUDE.md 갱신, 커밋 메시지 |
