young-0320/zynq-fir-decimation-ip/docs/asset/Fig 2. AXI stream signals.png

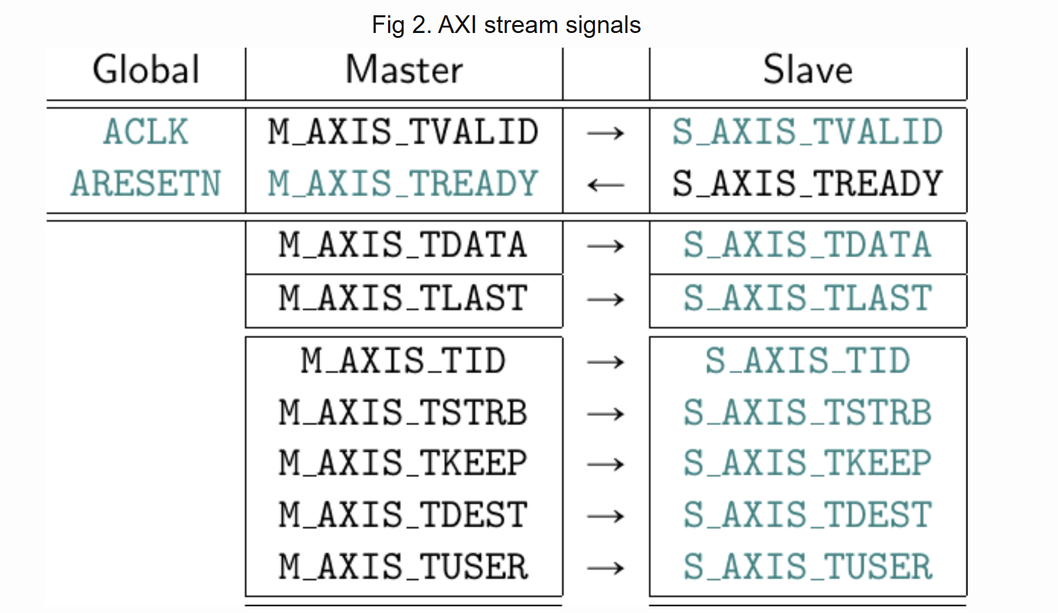
docs/asset/Fig 2. AXI stream signals.png
