young-0320/zynq-fir-decimation-ip/docs/asset/kaiser window.png

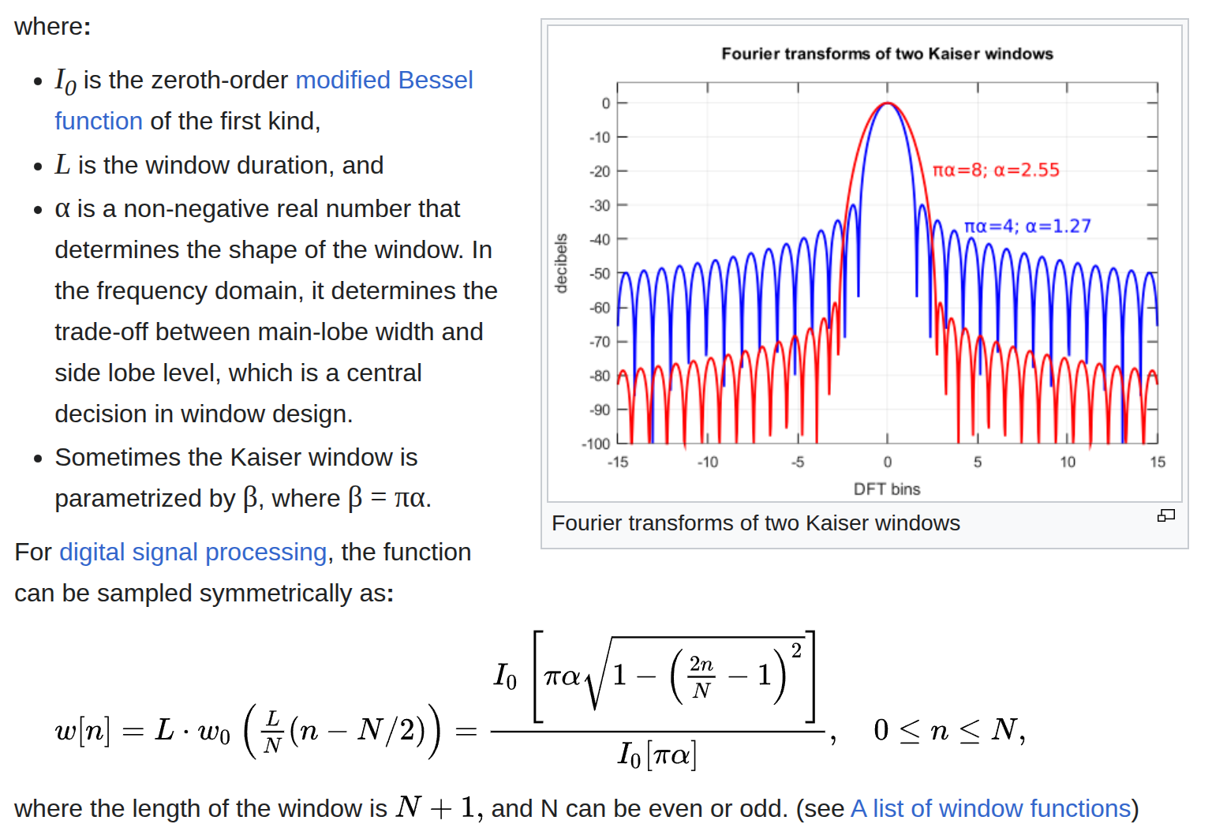
docs/asset/kaiser window.png
