young-0320/zynq-fir-decimation-ip/docs/report/fir_n43/plot/scenario1_2_fft.png

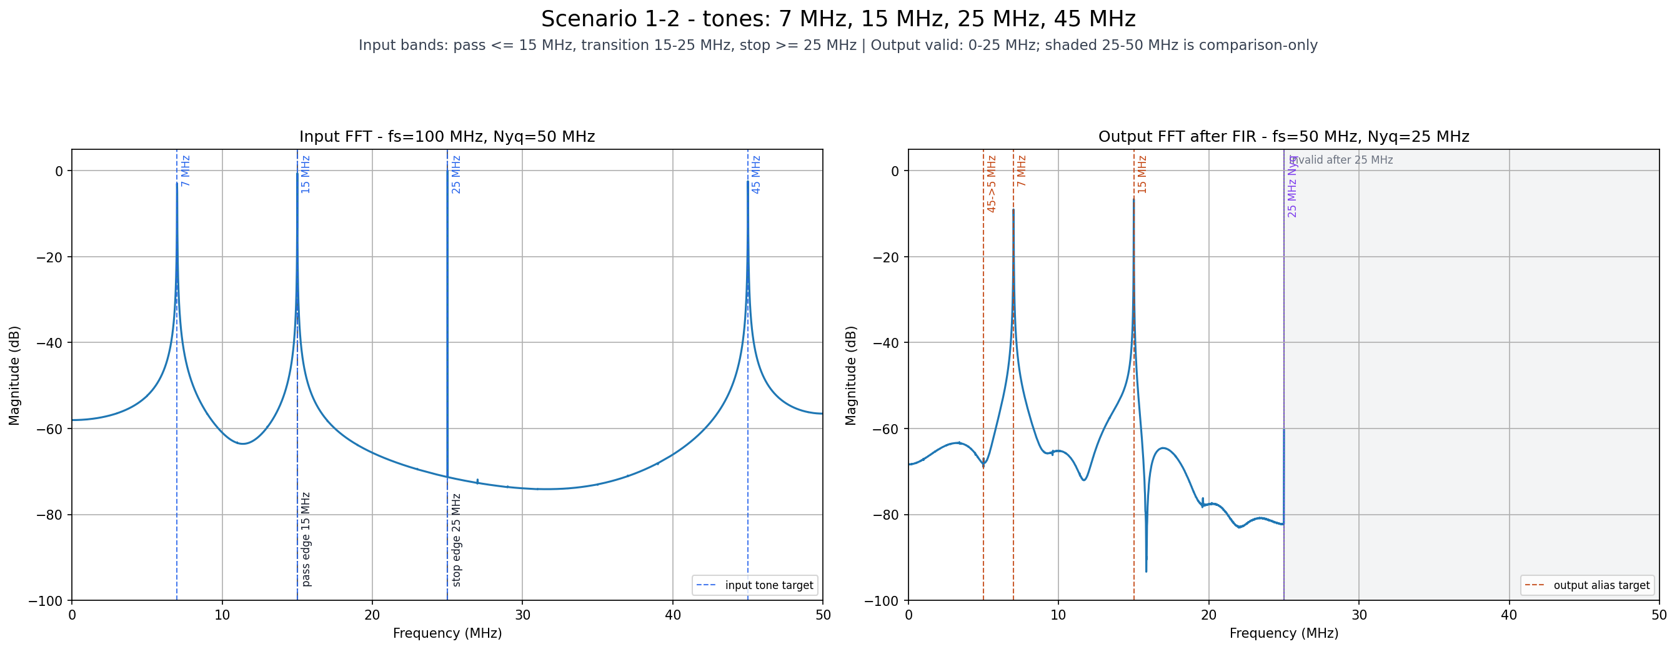
docs/report/fir_n43/plot/scenario1_2_fft.png
