young-0320/zynq-fir-decimation-ip/rtl/transposed_form/n43/fir_n43_v2.v

`timescale 1ns / 1ps
`default_nettype none

// FIR Transposed Form N=43 — v2 (120MHz 크리티컬 패스 보완, workflow_v21 참고)
//
// 설계 기준: docs/log/14_transposed_form_rtl_decisions.md
// v1(fir_n43.v) 대비 변경점: docs/workflow/workflow_v21.md
//
// v1은 Stage 2에서 누산과 round를 같은 사이클에 묶어 계산했다
// (round_reg <= round_q2_30_to_q1_15(prod_reg[0] + z[1])).
// 이 경로가 120MHz 타이밍 위반의 크리티컬 패스였다
// (vivado/reports/sweep_summary.md 참고, CARRY4x19 체인).
//
// v2는 누산(Stage 2)과 round(Stage 3)를 분리해 한 사이클 더 쓴다.
// round는 재계산 없이 레지스터에 저장된 z[0]을 그대로 읽는다.
//
// 파이프라인 4단계:
//   Stage 1: in_valid=1 → h[k]*in_sample → prod_reg[k]  (k=0..42 병렬)
//   Stage 2: prod_reg[k] + z[k+1] → z[k]  (누산만)
//   Stage 3: round(z[0]) → round_reg
//   Stage 4: saturate(round_reg) → out_sample
//
// Latency: 4 cycles (accepted input 기준, v1 대비 +1 cycle)
// z[k]   : signed 48-bit (Q2.30)
// 반올림 : ties-away-from-zero, 출력 1회
// 포화   : 출력 1회 clip(-32768, 32767)
// z[42]  : prod_reg[42] only (z[43] 없음, B안)
// 출력값은 v1과 100% 동일 (계산 순서만 재배치, 로직 자체는 변경 없음)

module fir_n43_v2 (
    input  wire               clk,
    input  wire               rst,
    input  wire               in_valid,
    input  wire signed [15:0] in_sample,
    output reg                out_valid,
    output reg signed  [15:0] out_sample
);

  // -----------------------------------------------------------------------
  // 계수 (Q1.15, ties-away-from-zero 반올림)
  // -----------------------------------------------------------------------
  localparam signed [15:0] COEFF_0 = 16'sd10;
  localparam signed [15:0] COEFF_1 = 16'sd0;
  localparam signed [15:0] COEFF_2 = -16'sd33;
  localparam signed [15:0] COEFF_3 = -16'sd32;
  localparam signed [15:0] COEFF_4 = 16'sd47;
  localparam signed [15:0] COEFF_5 = 16'sd107;
  localparam signed [15:0] COEFF_6 = 16'sd0;
  localparam signed [15:0] COEFF_7 = -16'sd197;
  localparam signed [15:0] COEFF_8 = -16'sd159;
  localparam signed [15:0] COEFF_9 = 16'sd206;
  localparam signed [15:0] COEFF_10 = 16'sd425;
  localparam signed [15:0] COEFF_11 = 16'sd0;
  localparam signed [15:0] COEFF_12 = -16'sd674;
  localparam signed [15:0] COEFF_13 = -16'sd522;
  localparam signed [15:0] COEFF_14 = 16'sd654;
  localparam signed [15:0] COEFF_15 = 16'sd1336;
  localparam signed [15:0] COEFF_16 = 16'sd0;
  localparam signed [15:0] COEFF_17 = -16'sd2258;
  localparam signed [15:0] COEFF_18 = -16'sd1939;
  localparam signed [15:0] COEFF_19 = 16'sd2995;
  localparam signed [15:0] COEFF_20 = 16'sd9864;
  localparam signed [15:0] COEFF_21 = 16'sd13109;
  localparam signed [15:0] COEFF_22 = 16'sd9864;
  localparam signed [15:0] COEFF_23 = 16'sd2995;
  localparam signed [15:0] COEFF_24 = -16'sd1939;
  localparam signed [15:0] COEFF_25 = -16'sd2258;
  localparam signed [15:0] COEFF_26 = 16'sd0;
  localparam signed [15:0] COEFF_27 = 16'sd1336;
  localparam signed [15:0] COEFF_28 = 16'sd654;
  localparam signed [15:0] COEFF_29 = -16'sd522;
  localparam signed [15:0] COEFF_30 = -16'sd674;
  localparam signed [15:0] COEFF_31 = 16'sd0;
  localparam signed [15:0] COEFF_32 = 16'sd425;
  localparam signed [15:0] COEFF_33 = 16'sd206;
  localparam signed [15:0] COEFF_34 = -16'sd159;
  localparam signed [15:0] COEFF_35 = -16'sd197;
  localparam signed [15:0] COEFF_36 = 16'sd0;
  localparam signed [15:0] COEFF_37 = 16'sd107;
  localparam signed [15:0] COEFF_38 = 16'sd47;
  localparam signed [15:0] COEFF_39 = -16'sd32;
  localparam signed [15:0] COEFF_40 = -16'sd33;
  localparam signed [15:0] COEFF_41 = 16'sd0;
  localparam signed [15:0] COEFF_42 = 16'sd10;

  // 반올림 상수: Q2.30 → Q1.15, bias = 2^(15-1) = 16384
  localparam signed [47:0] ROUND_BIAS = 48'sd16384;
  localparam signed [47:0] Q15_MAX = 48'sd32767;
  localparam signed [47:0] Q15_MIN = -48'sd32768;

  // -----------------------------------------------------------------------
  // Stage 1 레지스터
  // -----------------------------------------------------------------------
  reg signed [47:0] prod_reg[0:42];
  reg prod_valid;

  // -----------------------------------------------------------------------
  // Stage 2 레지스터 (누산)
  // -----------------------------------------------------------------------
  reg signed [47:0] z[0:42];  // delay register, Q2.30
  reg acc_valid;

  // -----------------------------------------------------------------------
  // Stage 3 레지스터 (round)
  // -----------------------------------------------------------------------
  reg signed [47:0] round_reg;
  reg round_valid;

  // -----------------------------------------------------------------------
  // 조합 논리: 16x16 → 32bit 곱셈, sign-extend → 48bit
  // -----------------------------------------------------------------------
  wire signed [31:0] prod_comb[0:42];
  wire signed [47:0] prod_wide[0:42];

  assign prod_comb[0]  = COEFF_0 * in_sample;
  assign prod_comb[1]  = COEFF_1 * in_sample;
  assign prod_comb[2]  = COEFF_2 * in_sample;
  assign prod_comb[3]  = COEFF_3 * in_sample;
  assign prod_comb[4]  = COEFF_4 * in_sample;
  assign prod_comb[5]  = COEFF_5 * in_sample;
  assign prod_comb[6]  = COEFF_6 * in_sample;
  assign prod_comb[7]  = COEFF_7 * in_sample;
  assign prod_comb[8]  = COEFF_8 * in_sample;
  assign prod_comb[9]  = COEFF_9 * in_sample;
  assign prod_comb[10] = COEFF_10 * in_sample;
  assign prod_comb[11] = COEFF_11 * in_sample;
  assign prod_comb[12] = COEFF_12 * in_sample;
  assign prod_comb[13] = COEFF_13 * in_sample;
  assign prod_comb[14] = COEFF_14 * in_sample;
  assign prod_comb[15] = COEFF_15 * in_sample;
  assign prod_comb[16] = COEFF_16 * in_sample;
  assign prod_comb[17] = COEFF_17 * in_sample;
  assign prod_comb[18] = COEFF_18 * in_sample;
  assign prod_comb[19] = COEFF_19 * in_sample;
  assign prod_comb[20] = COEFF_20 * in_sample;
  assign prod_comb[21] = COEFF_21 * in_sample;
  assign prod_comb[22] = COEFF_22 * in_sample;
  assign prod_comb[23] = COEFF_23 * in_sample;
  assign prod_comb[24] = COEFF_24 * in_sample;
  assign prod_comb[25] = COEFF_25 * in_sample;
  assign prod_comb[26] = COEFF_26 * in_sample;
  assign prod_comb[27] = COEFF_27 * in_sample;
  assign prod_comb[28] = COEFF_28 * in_sample;
  assign prod_comb[29] = COEFF_29 * in_sample;
  assign prod_comb[30] = COEFF_30 * in_sample;
  assign prod_comb[31] = COEFF_31 * in_sample;
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
  assign prod_wide[39] = {{16{prod_comb[39][31]}}, prod_comb[39]};
  assign prod_wide[40] = {{16{prod_comb[40][31]}}, prod_comb[40]};
  assign prod_wide[41] = {{16{prod_comb[41][31]}}, prod_comb[41]};
  assign prod_wide[42] = {{16{prod_comb[42][31]}}, prod_comb[42]};

  // -----------------------------------------------------------------------
  // 반올림/포화 함수 (v1과 동일)
  // -----------------------------------------------------------------------
  function automatic signed [47:0] round_q2_30_to_q1_15;
    input signed [47:0] value;
    reg signed [47:0] magnitude;
    reg signed [47:0] rounded_magnitude;
    begin
      magnitude = (value < 0) ? -value : value;
      rounded_magnitude = (magnitude + ROUND_BIAS) >>> 15;
      round_q2_30_to_q1_15 = (value < 0) ? -rounded_magnitude : rounded_magnitude;
    end
  endfunction

  function automatic signed [15:0] saturate_to_q1_15;
    input signed [47:0] value;
    begin
      if (value > Q15_MAX) saturate_to_q1_15 = 16'sd32767;
      else if (value < Q15_MIN) saturate_to_q1_15 = -16'sd32768;
      else saturate_to_q1_15 = value[15:0];
    end
  endfunction

  // -----------------------------------------------------------------------
  // Stage 1: 곱셈 → prod_reg
  // -----------------------------------------------------------------------
  integer i;
  always @(posedge clk or posedge rst) begin
    if (rst) begin
      prod_valid <= 1'b0;
      for (i = 0; i <= 42; i = i + 1) prod_reg[i] <= 48'sd0;
    end else begin
      if (in_valid) begin
        prod_reg[0]  <= prod_wide[0];
        prod_reg[1]  <= prod_wide[1];
        prod_reg[2]  <= prod_wide[2];
        prod_reg[3]  <= prod_wide[3];
        prod_reg[4]  <= prod_wide[4];
        prod_reg[5]  <= prod_wide[5];
        prod_reg[6]  <= prod_wide[6];
        prod_reg[7]  <= prod_wide[7];
        prod_reg[8]  <= prod_wide[8];
        prod_reg[9]  <= prod_wide[9];
        prod_reg[10] <= prod_wide[10];
        prod_reg[11] <= prod_wide[11];
        prod_reg[12] <= prod_wide[12];
        prod_reg[13] <= prod_wide[13];
        prod_reg[14] <= prod_wide[14];
        prod_reg[15] <= prod_wide[15];
        prod_reg[16] <= prod_wide[16];
        prod_reg[17] <= prod_wide[17];
        prod_reg[18] <= prod_wide[18];
        prod_reg[19] <= prod_wide[19];
        prod_reg[20] <= prod_wide[20];
        prod_reg[21] <= prod_wide[21];
        prod_reg[22] <= prod_wide[22];
        prod_reg[23] <= prod_wide[23];
        prod_reg[24] <= prod_wide[24];
        prod_reg[25] <= prod_wide[25];
        prod_reg[26] <= prod_wide[26];
        prod_reg[27] <= prod_wide[27];
        prod_reg[28] <= prod_wide[28];
        prod_reg[29] <= prod_wide[29];
        prod_reg[30] <= prod_wide[30];
        prod_reg[31] <= prod_wide[31];
        prod_reg[32] <= prod_wide[32];
        prod_reg[33] <= prod_wide[33];
        prod_reg[34] <= prod_wide[34];
        prod_reg[35] <= prod_wide[35];
        prod_reg[36] <= prod_wide[36];
        prod_reg[37] <= prod_wide[37];
        prod_reg[38] <= prod_wide[38];
        prod_reg[39] <= prod_wide[39];
        prod_reg[40] <= prod_wide[40];
        prod_reg[41] <= prod_wide[41];
        prod_reg[42] <= prod_wide[42];
        prod_valid   <= 1'b1;
      end else begin
        prod_valid <= 1'b0;
      end
    end
  end

  // -----------------------------------------------------------------------
  // Stage 2: 누산 → z[k] 갱신
  // -----------------------------------------------------------------------
  always @(posedge clk or posedge rst) begin
    if (rst) begin
      acc_valid <= 1'b0;
      for (i = 0; i <= 42; i = i + 1) z[i] <= 48'sd0;
    end else begin
      if (prod_valid) begin
        z[0] <= prod_reg[0] + z[1];
        z[1] <= prod_reg[1] + z[2];
        z[2] <= prod_reg[2] + z[3];
        z[3] <= prod_reg[3] + z[4];
        z[4] <= prod_reg[4] + z[5];
        z[5] <= prod_reg[5] + z[6];
        z[6] <= prod_reg[6] + z[7];
        z[7] <= prod_reg[7] + z[8];
        z[8] <= prod_reg[8] + z[9];
        z[9] <= prod_reg[9] + z[10];
        z[10] <= prod_reg[10] + z[11];
        z[11] <= prod_reg[11] + z[12];
        z[12] <= prod_reg[12] + z[13];
        z[13] <= prod_reg[13] + z[14];
        z[14] <= prod_reg[14] + z[15];
        z[15] <= prod_reg[15] + z[16];
        z[16] <= prod_reg[16] + z[17];
        z[17] <= prod_reg[17] + z[18];
        z[18] <= prod_reg[18] + z[19];
        z[19] <= prod_reg[19] + z[20];
        z[20] <= prod_reg[20] + z[21];
        z[21] <= prod_reg[21] + z[22];
        z[22] <= prod_reg[22] + z[23];
        z[23] <= prod_reg[23] + z[24];
        z[24] <= prod_reg[24] + z[25];
        z[25] <= prod_reg[25] + z[26];
        z[26] <= prod_reg[26] + z[27];
        z[27] <= prod_reg[27] + z[28];
        z[28] <= prod_reg[28] + z[29];
        z[29] <= prod_reg[29] + z[30];
        z[30] <= prod_reg[30] + z[31];
        z[31] <= prod_reg[31] + z[32];
        z[32] <= prod_reg[32] + z[33];
        z[33] <= prod_reg[33] + z[34];
        z[34] <= prod_reg[34] + z[35];
        z[35] <= prod_reg[35] + z[36];
        z[36] <= prod_reg[36] + z[37];
        z[37] <= prod_reg[37] + z[38];
        z[38] <= prod_reg[38] + z[39];
        z[39] <= prod_reg[39] + z[40];
        z[40] <= prod_reg[40] + z[41];
        z[41] <= prod_reg[41] + z[42];
        z[42] <= prod_reg[42];
        acc_valid <= 1'b1;
      end else begin
        acc_valid <= 1'b0;
      end
    end
  end

  // -----------------------------------------------------------------------
  // Stage 3: round(z[0]) → round_reg
  // -----------------------------------------------------------------------
  always @(posedge clk or posedge rst) begin
    if (rst) begin
      round_valid <= 1'b0;
      round_reg   <= 48'sd0;
    end else begin
      if (acc_valid) begin
        round_reg <= round_q2_30_to_q1_15(z[0]);
        round_valid <= 1'b1;
      end else begin
        round_valid <= 1'b0;
      end
    end
  end

  // -----------------------------------------------------------------------
  // Stage 4: 포화 → 출력
  // -----------------------------------------------------------------------
  always @(posedge clk or posedge rst) begin
    if (rst) begin
      out_valid  <= 1'b0;
      out_sample <= 16'sd0;
    end else begin
      if (round_valid) begin
        out_sample <= saturate_to_q1_15(round_reg);
        out_valid  <= 1'b1;
      end else begin
        out_valid <= 1'b0;
      end
    end
  end

endmodule

`default_nettype wire
