young-0320/zynq-fir-decimation-ip/(commit log)

2026-03-09 feat: add ideal fir-decimator chain and baseline path
2026-03-11 Add fixed-model scaffolding and shift workflow stages
2026-03-18 feat: add ideal-vs-fixed comparison flow
    [06_ideal_vs_fixed_compare_n5_metrics.csv]
2026-03-18 Add coefficient stopband spec check flow
2026-03-31 Update bring-up docs and add RTL placeholder
    [06_ideal_vs_fixed_compare_n5_metrics.csv]
2026-04-12 rtl: add bringup reset conditioner
    [reset_conditioner.v]
2026-04-12 docs: clarify bringup reset and auto-run flow
    [reset_conditioner.v]
2026-04-12 rtl: fix vivado memory init file lookup
    [top_zybo_bringup_n5.v]
2026-04-30 docs: add project direction change and transposed form design logs (#12–14)
    - 12: advisor feedback 반영 후 프로젝트 방향 전환 기록
    (N=43 Transposed Form 직접 진입, 100MHz Clocking Wizard, AXI 실시간 시연 목표)
    - 13: Transposed Form Q1.15 골든 모델 연산 정책 확정
    (wide 48-bit acc, ties-away-from-zero, 최종 출력 1회 반올림/포화)
    - 14: N=43 Transposed Form RTL 설계 결정 확정
    (1 sample/cycle 병렬, 2단계 파이프라인, FIR latency 2 cycles, localparam 하드코딩)
2026-04-30 docs: update workflow v7→v8 (golden model complete, RTL next)
2026-04-30 feat: add Q1.15 Transposed Form golden model
    - anti_alias_fir.py: 48-bit accumulator, ties-away-from-zero, final saturation only
    - fir_decimator_golden.py: FIR→Decimation chain wrapper
    - verified: Direct vs Transposed max diff = 0 LSB (bit-exact)
2026-05-03 feat(rtl): add fir_decimator_transposed_n43_top and tb, iverilog PASS
    fir_decimator_transposed_n43_top: fir_transposed_n43 + decimator_m2_phase0 연결 top.
    tb: expected_decim_q15.hex 4117 샘플 self-checking, PASS 확인.
2026-05-03 feat(vivado): add build TCL and update XDC for 100MHz timing closure
    zybo_n43.xdc: 100MHz 클럭 제약 추가 (IP 코어 타이밍 검증용, 보드 핀 제약은 AXI-Stream 단계에서).
    vivado/build_fir_transposed_n43.tcl: 프로젝트 생성 → synth → impl → timing report 자동화.
    CLAUDE.md: Step 2 완료, Step 3 시작으로 업데이트.
2026-05-03 fix(rtl): extend fir_transposed_n43 to 3-stage pipeline for timing closure
    2단계에서 WNS=-1.155ns 위반 → round_reg 스테이지 추가로 3단계 확장.
    Stage2: z[k] 업데이트 + round_reg 저장
    Stage3: saturate → out_sample
    결과: WNS=+0.278ns (100MHz 클로저), LUT=1827, DSP48=16.
    iverilog 두 TB 모두 PASS 재확인 (FIR 8234, decimator 4117 samples).
    [fir_transposed_n43.v]
2026-05-03 docs: add log 16 — Vivado timing closure for N=43 Transposed Form
    board_part 에러, WNS=-1.155ns 타이밍 위반, DSP48=0 오독 세 가지 트러블슈팅 기록.
    round_reg 스테이지 추가(3단계 확장)로 WNS=+0.278ns 클로저 달성한 과정 문서화.
2026-05-03 docs: update CLAUDE.md and log 16 style fixes
    CLAUDE.md: 3단계 파이프라인 다이어그램 반영, latency 수정(FIR 2→3, Top 3→4),
    로그 작성 규칙에 섹션 번호 형식(## 1) ) 추가.
    log 16: 섹션 번호 형식, --- 구분선, 결론 서술형, 메타데이터 위치 등 스타일 수정.
2026-05-03 fix(vivado): fix DSP48 filter and add utilization report to build TCL
    REF_NAME =~ DSP48* is the correct filter (PRIMITIVE_TYPE =~ DSP* always returns 0).
    Also removes board_part property (not installed on build machine) and adds
    report_utilization output alongside timing summary.
2026-05-03 docs: update hardware pipeline doc with demo scenarios 0/1/2
    Add scenario 0 (aliasing comparison without FIR) to explain why the
    system is necessary. Clarify scenario 1 (fixed signal) and scenario 2
    (interactive audience input) flow and role breakdown.
2026-05-03 docs: update CLAUDE.md — add demo scenarios and new doc file paths
    Add §5 demo scenarios (0 aliasing comparison / 1 basic / 2 interactive),
    add docs/study_roadmap.md and docs/하드웨어 파이프라인.md to directory
    structure section.
2026-05-04 fix: update decimator path, upgrade output buffer depth-2→depth-3
2026-05-04 chore: add decimator_m2_phase0 to transposed_form, fix CLAUDE.md formatting
    [decimator_m2_phase0.v]
2026-05-04 feat(step5): add AXI-Stream wrapper and TB for N=43 FIR decimator
    fir_decimator_transposed_n43_axis_top: depth-3 output buffer, TLAST_N=512,
    s_axis_tready=~valid2 stall. TB covers TREADY=1, backpressure 3:1, and
    aresetn recovery — all 3 scenarios PASS (4117 samples, bit-exact).
    [fir_decimator_transposed_n43_axis_top.v, tb_fir_decimator_transposed_n43_axis_top.v]
2026-05-04 refactor(step5-1): RTL 코드 스타일 통일 및 모듈 구조 README 추가
2026-05-04 test(step5-2): TB robustness 강화 — 전 계층 TB 재작성
2026-05-04 refactor(step5-1): 모듈 네이밍 정리 — transposed/top 중복 제거
    - transposed_form/ 하위 모듈에서 경로로 자명한 'transposed' 접미어 제거
    - board-level top이 없는 IP 코어이므로 모든 모듈에서 '_top' 제거
    - fir_transposed_n43 → fir_n43
    - fir_decimator_transposed_n43_top → fir_decimator_n43
    - fir_decimator_transposed_n43_axis_top → fir_decimator_n43_axis
2026-05-05 fix(axis): s_axis_tready = ~valid1으로 출력 버퍼 오버플로 수정
    ~valid2 기준으로 backpressure를 걸면 버퍼가 이미 full인 시점에서
    stall이 전파된다. valid2(registered) 기반 1-cycle 지연으로 샘플 1개가
    FIR에 누출되고, 2사이클 후 in-flight 출력이 도달할 때 버퍼가 여전히
    full이면 silently drop된다. TREADY 30% 조건에서 49% 확률 재현.
    ~valid1으로 변경해 valid2를 in-flight 출력의 완충 슬롯으로 확보.
    [fir_decimator_n43_axis.v]
2026-05-05 test: TB .v → .sv 재작성, scoreboard/watchdog/랜덤 버블 추가
    - NBA(<=) → blocking(=) + negedge 앵커 수정
    - int expected_q[$] scoreboard 큐로 순서 검증
    - watchdog timer 추가 (파이프라인 stall 감지)
    - drain loop timeout 추가
    - $signed() 캐스팅으로 push → 부호 불일치 수정
    - S2 랜덤 버블 주입, AXIS TB S3 reset recovery 추가
    - Makefile: .v → .sv TB 파일 참조 변경
2026-05-05 docs: step 5-2 로그 작성, CLAUDE.md 상태 업데이트
    log 18: 버퍼 오버플로 원인 분석 및 TB 재작성 내용 정리
    CLAUDE.md: Step 5-2 ✅ 완료, Step 6 현재 작업으로 전환
2026-05-05 test(axis): S2 백프레셔 시나리오에 TLAST 검증 추가
    check_mode 1→2: 랜덤 TREADY 30% 조건에서
    데이터 정합성뿐 아니라 TLAST 타이밍도 검증.
2026-05-05 docs: log 18 버그 원인 분석 설명 개선
    플립플롭 1-cycle 지연 개념을 더 쉽게 풀어 서술.
2026-05-06 feat(step7-8): bare-metal C + PC Python FFT 데모 스크립트 구현
    - sw/fir_decimator_demo.c: PS ARM 펌웨어 (DMA 제어, UART 송수신, 멀티톤 생성)
    - sw/fir_decimator_demo.py: PC FFT 시각화 (scenario 0/1/2, plt.ion() 실시간 갱신)
    - sw/test/test_fir_decimator_demo.py: 단위 테스트 25개 (happy path + edge case)
    - vitis/: Vitis 빌드 스크립트
    - vivado/bd_fir_dma.tcl: DMA Block Design TCL
    - docs/log/19-22: PS-PL DMA 설계, C 코드 설계, Vitis 빌드 절차, Python 설계 플랜
    - docs/데모 시나리오.md: 시나리오 0/1/2 정의
    - pyproject.toml: matplotlib, pyserial 의존성 추가, sw/test testpath 추가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
2026-05-06 docs: README 및 TCL 업데이트
2026-05-06 fix(vitis): C 소스 경로 ps/ → sw/ 수정, CLAUDE.md 업데이트
    vitis 빌드 스크립트가 존재하지 않는 ps/ 디렉토리를 참조하고 있어
    xsct 실행 시 즉시 실패하는 버그 수정.
2026-05-06 docs: workflow v10 업데이트, v11 보드 검증 가이드 작성
    Step 5~8 코드 완성 상태를 v10에 반영하고,
    보드 연결 후 Vitis 빌드 → UART 확인 → Python FFT 시각화
    순서를 v11에 정리.
2026-05-06 docs: CLAUDE.md 현재 단계 및 다음 절차 업데이트
    현재 위치를 Step 7로 수정하고 workflow_v11.md 참조와
    보드 검증 단계별 명령어 추가.
2026-05-06 docs: summary_design_decisions.md 최신화 (2026-03-09 → 2026-05-07)
    Step 5~8 완료에 따른 설계 결정 추가:
    - RTL 확정값 (3단계 파이프라인, 48-bit 누산기, symmetry 미사용)
    - AXI-Stream 래퍼 (aresetn, TLAST=512, depth-3 버퍼, TDATA=16bit)
    - PS-PL DMA 연동 (Module Reference, Simple DMA, HP0, bd_fir_dma.tcl)
    - bare-metal C + UART (N_IN/OUT, cache 정책, 패킷 마커)
    - PC Python FFT (mode 0/1/2, dB scale, x축 고정)
    - 미정 항목 전부 확정으로 정리
2026-05-06 docs: N=43 Transposed Form RTL spec 작성
    포트 계약, 3단계 파이프라인 latency, valid/reset 규칙,
    AXI-Stream 핸드셰이크, TB 검증 기준, 빌드 명령을 단일 문서로 정리.
2026-05-06 fix(rtl): fir_n43.v 파이프라인 주석 수정 (2단계→3단계, latency 2→3 cycles)
    타이밍 클로저 시 round_reg 삽입으로 3단계로 확장됐으나
    상단 주석이 갱신되지 않은 채 남아 있었음.
2026-05-06 feat(vivado): BD → 비트스트림 + XSA 자동화 스크립트 추가
    bd_fir_dma.tcl(BD 재생성)을 source하고 합성/구현/비트스트림/
    XSA 생성까지 한 번에 처리. XSA 경로는 vitis 빌드 스크립트와 일치.
2026-05-08 fix(vivado): UART1 PS7 설정 추가 + 빌드 경로 repo 내부로 수정
    bd_fir_dma.tcl:
    - PS7에 UART1 명시적 활성화 (MIO 48..49, 115200baud, IO PLL 100MHz)
    - 새 Vitis SDT 기반 BSP는 XSA에 명시된 주변장치만 포함하므로 필수
    - UART0 비활성화 (Zybo Z7-20 물리 핀 미연결)
    build_bd_fir_dma.tcl:
    - 빌드 경로 /mnt/workspace/ → $REPO_ROOT/build/vivado
    - XSA 출력 경로 → build/output/bd_fir_dma_wrapper.xsa
    - RTL 파일 경로 오류 수정: direct_form/ → transposed_form/
2026-05-08 fix(sw): UART_DEVICE_ID 수정 + Vitis 빌드 스크립트 Python으로 재작성
    fir_decimator_demo.c:
    - UART_DEVICE_ID: XPAR_XUARTPS_1_DEVICE_ID → 0
    - 새 SDT 기반 BSP는 UART1 단일 인스턴스를 canonical index 0으로 매핑
    build_fir_decimator_demo.py (신규, tcl 대체):
    - xsct TCL은 Vitis 2024.x에서 동작 불가 (--classic 제거됨)
    - vitis -s <script.py> Python API 방식으로 재작성
    - set_workspace → update_workspace, set_property → set_app_config
    - no_boot_bsp=True, generate_dtb=False (Lopper 오류 방지)
    - ELF을 build/output/으로 자동 복사
    build_fir_decimator_demo.tcl: 삭제 (deprecated)
    결과: build/output/fir_decimator_demo.elf 242KB 생성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
    [fir_decimator_demo.c]
2026-05-08 docs(log): Vitis ELF 빌드 트러블슈팅 기록 추가 (log 23)
    xsct → Python 전환 과정에서 발생한 7가지 문제 상세 기록:
    1. xsct PATH 문제 (xsct-trim/bin/ 경로 분리)
    2. xsct --classic 에러 (Vitis 2024.x deprecated)
    3. workspace 버전 불일치 (update_workspace로 전환)
    4. Lopper null 경로 (Vitis Embedded Development 미설치)
    5. Lopper pip install 실패 (AMD 설치 버그 → 수동 설치)
    6. xuartps.h 미포함 (SDT BSP는 명시적 UART 활성화 필요)
    7. XPAR_XUARTPS_1_DEVICE_ID 미정의 (canonical index 변경)
2026-05-08 docs(log): workflow_v11 Step 7 보드 검증 절차 업데이트
    - Step 7-A: xsct TCL → vitis -s Python 명령어 수정
    - Step 7-B: Vitis GUI → xsdb 커맨드라인 절차로 교체
    - 환경 설정: ~/.bashrc 등록 → 터미널 세션당 1회 수동 소싱 방식으로 변경
    - 트러블슈팅 표: xuartps.h, DEVICE_ID, Lopper 항목 추가
    - 경로 전체 /mnt/workspace/ → build/output/ 수정
2026-05-08 docs: README 사전 조건 상세화 + CLAUDE.md Step 7 완료 반영
    README.md:
    - 사전 조건을 4개 섹션으로 확장
    - Vitis Core vs Vitis Embedded Development 차이 명시
    - Lopper AMD 설치 버그 및 수동 설치 방법 추가
    - settings64.sh 소싱 필수 안내
    - 의존성 버전 표 + Ubuntu 설치 명령어
    - vivado 명령어에 -journal/-log 플래그 추가 (중간 산출물 repo 루트 오염 방지)
    - xsct → vitis -s 명령어 수정
    - 트러블슈팅 로그 링크 추가
    CLAUDE.md:
    - Step 7: 🔄 → ✅ ELF 생성 완료 (242KB)
    - 다음 절차: xsct → xsdb + vitis -s 명령어로 수정
    - Updated 날짜: 2026-05-08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
2026-05-08 chore: 마크다운 포맷 정리 + 불필요 파일 삭제
    - workflow_v9.md, 데모 시나리오.md: 테이블 정렬 및 공백 자동 포맷 적용
    - summary_design_decisions.md: 삭제 (내용이 CLAUDE.md와 중복, 관리 단일화)
    - .gitignore: PROJECT_CONTEXT.md 제외 항목 삭제 (파일 삭제에 따른 정리)
2026-05-08 fix(vivado): build_fir_transposed_n43.tcl 경로 repo 내부로 수정
    BUILD_DIR: 하드코딩된 /mnt/workspace/ → $REPO_ROOT/build/vivado
2026-05-08 feat(vitis): 보드 다운로드 xsdb TCL 스크립트 추가
    vitis/download_and_run.tcl:
    - xsdb vitis/download_and_run.tcl 한 줄로 비트스트림 + ELF 다운로드
    - REPO_ROOT 기준 절대 경로 자동 계산
    - Step 7~9 (보드 다운로드 → UART → Python FFT) 명령어 추가
    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
2026-05-08 fix(vitis): download_and_run.tcl DDR 초기화 순서 수정
    rst -processor → rst -system 으로 변경.
    rst -processor는 CPU만 리셋해 DDR 컨트롤러가 초기화되지 않아
    dow 시 "Cannot access DDR: the controller is held in reset" 에러 발생.
    rst -system → BootROM 실행 → DDR 초기화 완료 후 fpga/dow 진행.
2026-05-08 fix(vitis): ps7_init으로 DDR 컨트롤러 초기화
    FSBL 없이 JTAG으로 부팅 시 DDR 컨트롤러는 BootROM/FSBL이
    초기화해줘야 한다. rst -system만으로는 xsdb 환경에서 DDR이
    초기화되지 않아 dow 시 "Cannot access DDR" 에러 발생.
    Vivado BD가 생성한 ps7_init.tcl을 source해 ps7_init/ps7_post_config
    프로시저로 DDR, PLL, MIO를 직접 초기화 후 ELF 다운로드.
2026-05-09 fix(rtl): TLAST_N 512 → 4096으로 수정
    DMA 전송 단위(N_OUT=4096 샘플)에 맞게 TLAST 생성 주기 수정.
    기존 512는 N_IN/4 기준으로 잘못 설정되어 있었음.
    via [Happy](https://happy.engineering)
    [fir_decimator_n43_axis.v]
2026-05-09 fix(sw): DMA soft reset 추가 + UART READY 메시지 출력
    - dma_run() 진입 시 MM2S DMACR bit2로 AXI DMA soft reset → 이전
    펌웨어 실행의 stale DMA 상태 제거 (PG021 기준)
    - main() 진입 시 "READY\r\n" 출력 → PC에서 보드 준비 상태 확인 가능
    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
    [fir_decimator_demo.c]
2026-05-09 fix(vitis): xsdb JTAG byte3 버그 우회 — dow → mwr+mrd 방식으로 전환
    xsdb의 `dow` 명령 및 연속 `mwr` 사용 시 각 워드의 MSB(byte 3)가
    다음 JTAG 명령 전까지 플러시되지 않는 버그 존재.
    - gen_mwr_tcl.py: ELF PT_LOAD 세그먼트를 파싱해 mwr+mrd 쌍으로 된
    Tcl 스크립트를 생성 (mrd가 write buffer flush 강제)
    - download_and_run.tcl: dow 대신 생성된 load_elf.tcl을 source,
    L2 캐시 무효화(PL310 0xF8F0277C) 추가
    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
2026-05-09 docs: JTAG 다운로드 트러블슈팅 기록 추가 (log 24) + test_uart.py
    - 24_jtag_download_troubleshooting.md: DDR 접근 불가, byte3 오염,
    L2 캐시 stale 등 xsdb 부팅 과정에서 발생한 문제 기록
    - 23번 문서 말미에 24번 참조 링크 추가
    - test_uart.py: UART 응답 확인용 간단한 테스트 스크립트
    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
2026-05-11 docs: 파이프라인 정리
2026-05-11 fix(rtl): resolve AXI-Stream TLAST deadlock in FIR wrapper
    [fir_decimator_n43_axis.v]
2026-05-11 chore:workflow 정리
2026-05-11 fix : change cmd buffer flushing mechanism
    [fir_decimator_demo.c, test_uart.py]
2026-05-11 docs : 25_md와 25_axi_stream_tlast_deadlock_troubleshooting.md 내용 병합
2026-05-12 zybo z7-20 파일 추가
2026-05-12 docs: 25, 26파일 수정
2026-05-12 ddr 접근 실패 수정 시도
    [fir_decimator_demo.c]
2026-05-13 docs: 26/27 디버그 리포트 작성 및 download_and_run.py pexpect 버그 수정
    - 26: 파일명 정규화, DDR 파트 오설정·AXI-Stream 인터페이스 규칙 문서화
    - 27: DDR MSB 소실 디버깅 리포트 신규 작성 (Phase 1-8)
    - JTAG byte[3] 파이프라인 버그(log 24)와 ps7_init.tcl DDR 파트 불일치를
    별개 이슈로 재규명. Phase 1-8 조사 방향 오류 정정.
    - download_and_run.py: DDR sanity check sys.exit → 경고로 완화,
    mrd 파싱을 cmd() 대신 직접 sendline/expect로 교체 (pexpect 버그 수정)
2026-05-13 docs: JTAG ELF 로딩 최종 실패 정리 및 SD카드 부팅 전환 결정
    - 27: Phase 8-6 결과 업데이트(pexpect REPL barrier도 byte[3] 오염 재발),
    Phase 9 추가(dow 반복 테스트 — F9/F2/F4 비결정적 오염, Data Abort 크래시),
    최종 결론 섹션 추가(시도 방법 전체 요약, 미해결 원인 두 가설, SD카드 전환 결정)
    - 24: 상태 ❌ 업데이트, pexpect REPL barrier도 실패 확인 반영, 핵심 교훈 6 추가
    - 25: 상태 ❌ 업데이트 (JTAG 로딩 실패로 보드 검증 미완)
    - 26: 보드 검증 상태 SD카드 전환으로 업데이트
    - download_and_run.py: 잘못 추가된 mrd flush 롤백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
2026-05-13 docs: SD카드 부팅 전환 — workflow_v12 작성, CLAUDE/README 갱신
    JTAG ELF 로딩이 DDR byte[3] 비결정적 오염으로 미해결 종료(log 24, 27).
    SD카드 부팅으로 전환 결정(2026-05-13). Block Design 재생성 후
    ps7_init.tcl을 Digilent 레퍼런스와 일치시킨 상태에서 BOOT.bin 패키징,
    SD 부팅으로 검증. 실패 시 HW 결함으로 좁혀짐.
    - docs/workflow/workflow_v12.md 신규: BD 재생성 → ps7_init diff →
    Vitis 재빌드 → bootgen → SD 부팅 절차 정리, 실패 분기/HW 결함 판정 기준 포함
    - CLAUDE.md: Updated 날짜, Step 7/8 상태와 다음 단계를 v12 기준으로 갱신
    - README.md: 빌드 순서 7~10단계를 SD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
2026-05-23 Document SD boot bringup and DMA diagnostics
2026-05-23 Fix AXI DMA length width and add smoke debug flow
    [fir_decimator_demo.c, fir_decimator_demo.py]
2026-05-24 chore: move legacy UART smoke script out of root
2026-05-25 Add FIR N43 board report evidence
2026-06-29 feat: CPU vs FPGA FIR 처리 시간 비교 구현 (workflow v18)
    교수님 피드백 반영. CPU(numpy float64) vs FPGA(XTime 실측) 비교.
    - sw/cpu_benchmark.py: numpy float64 FIR 벤치마크, CV 수렴 루프,
    --port 옵션으로 보드 타이밍 자동 수신, 비교 표 + 바 차트 출력
    - sw/fir_decimator_demo.c: XTime 타이머 삽입 (MM2S kick~S2MM IDLE),
    uart_putu32() 추가, FIR_TIME_US:%u UART 출력
    - sw/fir_decimator_capture.py: Q15CaptureResult NamedTuple 추가,
    FIR_TIME_US 파싱, float 경로는 기존 반환 타입 유지
    - sw/test/test_fir_decimator_capture.py: 반환 타입 변경 반영,
    board_time_us 파싱 테스트 추가 (36 passed)
    - docs/workflow/work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
2026-06-30 fix: Vitis 2024.2 SDT 모드 xtime_l.h 빌드 오류 수정
    - fir_decimator_demo.c: XPAR_CPU_CORTEXA9_0_CPU_CLK_FREQ_HZ compat define 추가
    (SDT 모드에서 xparameters.h가 해당 매크로를 정의하지 않아 빌드 실패)
    - rebuild_boot_image.sh: xtime_l.h가 export include에 없을 때 BSP 소스에서 자동 복사
    [fir_decimator_demo.c]
2026-06-30 feat: 주파수 스윕 루프 에이전트 설정
    - vivado/README.md: 동적 주파수 결정 알고리즘 기반 루프 에이전트 지침 작성
    - vivado/fir_n43/build_bd_fir_dma.tcl: report_power 추가
    - vivado/reports/: 100 MHz 기준점 rpt 3개 추가 (WNS=+0.692ns)
2026-06-30 fix: vivado/reports/*.rpt gitignore 예외 추가 및 100 MHz 기준점 리포트 추가
2026-06-30 feat: 주파수 스윕 빌드 결과 rpt 추가 (90/110/115/120 MHz)
    - 90 MHz: WNS=+1.883ns (PASS)
    - 110 MHz: WNS=+0.178ns (PASS)
    - 115 MHz: WNS=+0.178ns (PASS)
    - 120 MHz: WNS=-0.783ns (FAIL)
2026-06-30 feat: 클럭 스윕 완료 — Fmax=115 MHz, sweep_summary.md 생성
    - sweep_summary.md: 5개 주파수 포인트 결과 정리
    - bd_fir_dma.tcl: 100 MHz 원복
    - README.md: 체크리스트 전체 완료 표시
2026-06-30 docs: 스윕 루프 체크리스트 최종 완료 표시
2026-06-30 docs: log37 완료 확인 업데이트, log38 교수님 미팅(7-2) 정리 추가
    CPU vs FPGA 벤치마크 및 Fmax 주파수 스윕 완료 내용 포함.
2026-06-30 fix: vivado/reports .rpt gitignore 복원, sweep_summary.md 크리티컬 패스 분석 추가
    - .gitignore: *.rpt 예외 제거 (rpt는 로컬 빌드 산출물), sweep_summary.md만 추적
    - sweep_summary.md: 120 MHz 크리티컬 패스 분석 및 v2.0 방향 추가
2026-06-30 docs: workflow v20 초안 작성 — 115 MHz 보드 정확도 검증 및 v1.0 완료 절차
2026-07-01 feat: 120MHz 크리티컬 패스 분석, FIR v2 파이프라인 분할 설계 시작
    log38에 교수님 미팅(7-2) 실제 피드백 추가: 방향성 승인, ASIC(OASIS/Nitro)
    보조 지표화, CPU 벤치마크 PNG 스펙 기입, HDS242 전력 실측 지시.
    120MHz 타이밍 실패 크리티컬 패스(누산+라운딩 동시 계산으로 인한
    CARRY4x19 체인)를 분석하고, fir_n43_v2.v로 누산/라운딩 파이프라인을
    분리해 병목을 제거하는 설계를 별도 파일로 작성 (v1 fir_n43.v는 무수정
    보존). Stage A(iverilog 기능 검증) 파일까지 준비, Stage B(Vivado 재스윕)
    전 단계.
    [fir_n43_v2.v, tb_fir_n43_v2.sv]
2026-07-02 feat: FIR v2 4단 파이프라인 통합 + clk_wiz 정밀 주파수 스윕 (Fmax v1 116 / v2 146)
    - Stage B v2 통합: fir_decimator_n43_v2, _axis_v2, bd/build tcl 생성; 통합 iverilog S1/S2/S3 PASS
    - clk_wiz(MMCM) overlay로 target=actual 정확 분주 → PS PLL 정수분주 스냅(요청≠실제) 문제 해결
    - v1 재측정: Fmax 116 MHz (기존 "115"는 실제 111.111 오라벨 → 정정)
    - v2: Fmax 146 MHz(+30MHz). 크리티컬 패스가 FIR round → AXI DMA IP로 이동, FIR 추가 최적화 불필요
    - sweep_summary.md(v1)/sweep_summary_v2.md(v2) clk_wiz 데이터로 재작성, log 40 기록
    - 130 MHz 골든 배포 빌드(bit/xsa) 보존
2026-07-02 fix: Fmax와 골든(보드 구동) 주파수 분리, 빌드 경로 재현성 개선
    - v1/v2 모두 Fmax(정적 타이밍 상한, 여유 거의 0)와 골든(안전마진 확보한 실배포 주파수)을 분리
    v1: Fmax 116 -> 골든 115 (+0.231ns), v2: Fmax 146 -> 골든 145 (+0.129ns, 146보다 마진 6배)
    - clk_wiz 빌드 스크립트가 -tclargs 주파수로 출력 디렉터리(build/fir_n43_v{1,2}_freq_<N>mhz/)를
    자동 결정하도록 변경 -> 수동 복사 없이 동일 명령 재실행만으로 다른 머신에서도 재현 가능
    - docs/build_artifacts.md 신규: 전체 산출물 경로/용도/재현 명령 매니페스트, CLAUDE.md에서 링크
    - 레거시 build/output(어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
2026-07-02 test: AXIS skid buffer 4개 버그 재현 TB 편입 + 조사 log41 / 계획 wf22
    새 세션 핸드오프 준비. AXIS 래퍼(fir_decimator_n43_axis[.v/_v2.v])의 skid buffer
    관련 4개 버그를 iverilog로 재현.
    - sim/rtl/tb/transposed_form/tb_skid_stress.sv: v1/v2 래퍼 동시, 연속 입력 +
    지속 backpressure. 버그 1~4 재현(드랍/데드락/경계 오염/홀수 target).
    - sim/rtl/tb/transposed_form/tb_buf_depth.sv: 버그 1 격리, 버퍼 깊이 스윕.
    현재 게이트(~valid1) 4칸 필요, ~valid0면 3칸.
    - sim/Makefile: v2 RTL 소스 리스트 + `make run_bug` 타깃 추가.
    미수정 상태라 run_bug은 FAIL(재현). 버그 1 수정 성공 기준 = run_bug PASS.
    -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
    [tb_buf_depth.sv, tb_skid_stress.sv]
2026-07-02 docs(wf22): AXIS 버그 1~4 수정 설계 확정 (짝수 전용, v1v2, 코어 무수정)
    결정 2개 잠금 후 에이전트 핸드오프용 구현 스펙 추가.
    - 짝수 길이 전용(홀수 미지원, decimator 코어 무수정, 주석만)
    - v1·v2 래퍼 둘 다 동일 수정
    - 버그1: skid 3→4칸 / 버그3: flush 0-주입 제거 / 버그2: 종료판정 >= +
    TLAST 코어출력 태깅 / 버그4: 짝수에서 target 공식 이미 정확, 로직 무변경
    - 수용 기준: run_all 유지 + tb_skid_stress 멀티패킷 업그레이드 후 run_bug PASS
    확인 필요 2·3 해결 표시, 실행 순서표 갱신.
2026-07-02 fix: AXIS 래퍼 skid buffer 버그 1~4 수정 (wf22 설계 + tready |tlast 추가)
    - skid buffer 3→4칸 (log 41 실측 근거: 게이트 허용 2 + in-flight 2)
    - flush 0-주입 제거 (버그 3 경계 오염 근본책), 종료 판정 == → >=
    - 계획에 없던 추가: s_axis_tready에 | s_axis_tlast — backpressure로
    tlast 수락이 지연될 때 TLAST 태깅 레이스 제거 (log 42 §2)
    - tb_skid_stress 2패킷 무리셋 + 절대 assert로 업그레이드
    - 검증: make run_bug / run_all PASS (log 42)
    [fir_decimator_n43_axis.v, fir_decimator_n43_axis_v2.v, tb_skid_stress.sv]
2026-07-02 fix: Tcl 안내 메시지 $OUT_DIR 정정 + bd_fir_dma_v2 PCW 100MHz 원복 (wf22 부수 이슈 2건)
    - build 스크립트 3종의 puts 안내가 v1 100MHz 경로를 하드코딩하던 것을
    실제 산출 경로($OUT_DIR)로 정정 — 잘못된 bit로 BOOT.bin 만드는 오귀속 방지
    - bd_fir_dma_v2.tcl의 임시 PCW_CLK0/FPGA0 125MHz를 100MHz로 원복 (재현성)
2026-07-02 docs: workflow_v23 — 교수 피드백 4건(ASIC/전력/CPU스펙/문서) 트랙 계획
    주체별(사용자 물리작업 vs 에이전트) 분리, v22(AXIS 수정)와 트랙 분리 및 의존 순서 정리
2026-07-02 fix: AXIS 래퍼 hold-back — tlast 직전 tvalid 버블 데드락 수정 (log 43/44)
    코드 리뷰에서 확정된 잔존 버그: tlast 직전 마스터 버블 >=3(v1)/>=4(v2)사이클이면
    마지막 코어 출력이 target/waiting 확정 전에 태그 없이 나가 TLAST 영구 유실 +
    래퍼 영구 정지 (directed sim으로 임계값 정확 재현).
    - pend_valid/pend_idx: 길이 미확정 최신 출력 추적, 확정 전 m_axis 노출 금지
    - tlast 수락 시 소급 태깅 + 같은 사이클 즉석 태깅 + 즉시 종결 + 종료판정 레벨화
    - 버퍼 4칸 불변 (hold는 점유 1일 때만 — 불변식 주석)
    - tb_tlast_bubble.sv 신규: 버블 0~6 x v1/v2 x 자유/backpressur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
    [fir_decimator_n43_axis.v, fir_decimator_n43_axis_v2.v, tb_tlast_bubble.sv]
2026-07-02 docs: 수정 RTL 골든 재빌드 검증 반영 — v1@115/v2@145 WNS 불변, Fmax 116/146 유효
    - sweep_summary(.md/_v2.md)에 재빌드 검증 절 추가: 골든 주파수 WNS/LUT/전력
    전 수치 수정 전과 동일, 크리티컬 패스 불변 → 재스윕 불필요 판정
    - BOOT.bin 재생성 완료 (v1: FIR / v2: FIR_V2 태그), CLAUDE.md 상태 갱신
    - 100MHz 골든 산출물(build/fir_n43/output)은 실보드 검증 이력 보존 위해 무수정
2026-07-02 docs: log 45 — 수정 RTL 골든 재빌드(WNS 불변)·BOOT.bin 준비 기록
2026-07-02 docs: 문서화·재현성 정합성 정리 — 산출물 소속 커밋 명시, 이력 문서 [갱신] 주석
    - build_artifacts.md: 115/145(수정 RTL, 6a4bf36) vs 100MHz baseline(수정 전 RTL 보존본)
    소속 구분 + "재현 명령 재실행 시 보존본과 달라짐" 경고 + BOOT.bin 재현 명령 추가
    - README: known limitation에 수정 상태 정확화(정상 반복=RTL 수정, 100MHz 산출물은
    구RTL 보존, abort 경로는 잔존), RTL sim 절에 make run_bug 추가
    - log 42: 잔존 데드락(log 43/44) 및 Tcl 수정 완료 [갱신] 주석
    - workflow_v23: v22 트랙 완료 [갱신] + §5.1 "해소"를 "부분 해소"로 정정
2026-07-03 docs+feat: 보드 실측 완료 기록, CPU 벤치 PNG 스펙/방법론 주석 로직 추가
    v1@115MHz/v2@145MHz BOOT.bin 보드 기능 검증(mode 1-1) 완료를 CLAUDE.md/
    workflow_v23.md에 반영. cpu_benchmark.py에 CPU 스펙 및 측정 방법론 텍스트를
    차트에 기입하는 로직 추가(Windows i5-1340P 기준, §8-2).
2026-07-03 docs: Track B 전력 실측 확정(B1/B2/B3)·log46/wf23 스코프 분리, v2 코어 단독 util/전력 추출
    - log 46: 측정 방식 의사결정(5V 입력+상태 차분, v2@145 대상, 희생 USB VBUS 절단)·근거·한계 기록
    - workflow_v23 Track B: 준비물 체크리스트·결선·실행 절차(S0/S1/S2)·기록 양식, 12V→5V 오기 정정
    - sweep_summary_v2: 코어 단독 utilization/전력 절 추가 — u_fir_n43_v2 LUT 1792/FF 2113/DSP 16/0.015W
    (전체 비트스트림 4556 LUT/1.705W와 구분, ASIC Track A 비교 기준)
    - workflow_v23 Track A ⚠(전체 비트스트림 수치 혼동 주의) → 해소 처리
2026-07-21 feat: ASIC flow(Track A) 실행 준비 — v1/v2 Oasys config·Nitro 템플릿, A1 v1+v2 확정
    - workflow_v23 A1 갱신: ASIC 대상 = v1+v2 둘 다(동일 제약) — CARRY4 병목의
    FPGA 전용성 가설을 실증하는 구도로 재해석. A2 해소(GEMM 프로젝트와 동일 환경,
    Tanner Generic 250nm, 클럭은 20000→8000ps sweep + 이분탐색)
    - asic/oasys: v1/v2 config(소스 1파일이라 filelist 없이 직접 기재), 공용 clk.sdc,
    README(절차·export 명령·sweep 범위 근거)
    - asic/nitro: 템플릿 tcl(GEMM step2 기반, chip area 3000000a 시작), README
    - .gitignore: asic/**/*.rpt 예외 — 서버 산출물 git 회수용
2026-07-21 asic: reextract 20000ps power report
2026-07-21 asic: add sweep_report with 20000ps pair analysis, update power extraction notes
2026-07-21 asic: sweep_report 15000ps — v1 bottleneck shifts to merged round path, v2 5x slack
2026-07-21 asic: rewrite export.tcl as session proc — 'ex v1 12000ps' per run
2026-07-21 asic: auto-source export.tcl from configs — 'ex' available without manual source
2026-07-21 asic: sweep_report 12000ps — gap narrows, shared multiply-path floor ~10ns emerges
2026-07-21 asic: sweep_report 10000ps — both pass 100MHz, converge to rounding-add bottleneck, v1 slight edge
2026-07-21 asic: sweep_report cleanup — drop orphaned 20000ps area bullet from 10000ps block
2026-07-21 asic: sweep_report 9000ps — both pass 111MHz, rank oscillates within noise, 8000ps is the discriminator
2026-07-21 asic: sweep_report 8000ps — both pass 125MHz, 20ps apart, no structural gap on ASIC confirmed
2026-07-21 asic: sweep_report 6000ps — both pass 166.7MHz, stop sweep, final conclusion recorded
2026-07-21 asic: track only P&R-input netlists (10000/12000ps), drop the other 8 (~16MB)
2026-07-21 asic: fix REPO_ROOT in nitro tcls/template — missing ddl2026_folder path segment
2026-07-21 asic: split nitro flow into per-pause step tcls — chunked source, no copy-paste
2026-07-21 asic: fix Nitro chip area 300um -> 1.4mm — FIR cell area 1.35mm2 (43 multipliers), 15x undersized before
2026-07-21 asic: drop place_macros step — datapath blocks are std-cell groups (PLC1020), placed by run_place_timing
2026-07-21 asic: step1 message — manual datapath block drag required before rows (route fails if left outside)
2026-07-21 asic: enlarge nitro chip 1.4mm -> 1.6mm — placer SDA101 density crash at util 70
2026-07-21 docs: asic_vs_fpga — fill FPGA area cell with device utilization %, add footnote
2026-07-21 docs: close Track A — synthesis complete, Nitro halted on tool-internal SDA101 bug, records kept
2026-07-21 docs: log 47 — Track A full record (Oasys sweep, interpretation shifts, incidents, Nitro halt)
2026-07-21 docs: fix mangled line in workflow_v23 Track A (sed ampersand artifact)
2026-07-21 docs: 결과보고서 양식
2026-07-22 docs: Track B 전력 실측 완료 — log 46 §5 기록 + Vivado 비교 리포트
    - log 46 §5: 배럴잭 breakout 경로 변경, 측정 조건, raw 판독값(시간 순),
    차분·부가 관찰, 결선도(전류 직렬/전압 브리지)
    - summary/power_board_vs_vivado.md 신규: 측정표, 차분 해석, Vivado 1.705W
    대비 분해(USB-UART 0.22W 실측 분리), 한계 고지, raw 부록 A, 결선 부록 B
2026-07-22 docs: D2 — A/B/C 보조지표 v1.0 문서 통합, TrackB 플레이스홀더 해소
    - sweep_summary/_v2: 보조지표 교차 참조 절 추가, correctness 보드 확인 반영
    - final_report_draft §5.2/§6, presentation_outline 슬라이드12·Q&A: 실측값 반영
    - workflow_v23: Track B ✅(배럴잭 경로 갱신), §5.1 반복 실행 해소 확정,
    상태 표 A/B/D2 완료 표시
2026-07-22 docs: log 48 — 5차 미팅(7/29) 보고자료
    전력·ASIC 결과 보고 대본, 예상 질문 답변, v1↔v2 결정 논의 표(v2 제안),
    지난 지시(log38 §8) 4건 완료 현황. §4 미팅 피드백은 미팅 후 기록
2026-07-22 docs: workflow_v24 마무리 체크리스트 + CLAUDE.md M4 상태 갱신
    - v24: 결과보고서 제출~최종 발표(8/7)~공개 자산화 체크리스트(기한 순 8절),
    공개 톤 정리 계층화 전략(Tier 1 관문 문서만 정리, log 원본 보존)
    - CLAUDE.md: Track A/B/D2 완료 반영, 남은 작업 = v1↔v2 결정·발표 준비
2026-07-22 docs: 결과보고서 Ⅰ장 초안 전문 + 제출 전 수정 문안 보존본
    hwp Ⅰ장 붙여넣기용 초안(실측 반영판)과 Ⅱ~Ⅵ 수정 문안 8건 — 대화 유실 대비
2026-07-22 docs: 공개용 문서 톤 정리(Tier 1) + docs/log 안내문(Tier 2)
    - 관문 문서 6종 문체 정리 (수치·내용 불변): power_board_vs_vivado,
    asic_vs_fpga, sweep_summary/_v2, sweep_report, build_artifacts
    — 장식용 볼드·이모지·메타 표현 제거, 표 칸의 논평을 본문 서술로 이동
    - sweep_report는 실험 노트 성격 유지 (단락 제목 볼드·해석 변천 취소선 보존)
    - docs/log/README.md 신규: log 폴더를 가공하지 않는 개발 기록 원본으로 명시
2026-07-22 docs: README를 소개 중심으로 재작성, 빌드·데모 절차는 getting_started로 분리
    - README: 정의·결과 요약 표(헤드라인 5개)·차별점 4가지·Quick Start·문서 지도
    구조로 재작성. 낡은 정보(workflow_v15/16 링크, 완료된 Next Work) 제거
    - docs/getting_started.md 신규: Prerequisites, 빌드 3단계, 검증 파이프라인,
    Fast Rebuild, 디버그 플로우 이관 + back-to-back 제약 서술을 수정 RTL
    보드 확인(log 46 §5) 반영으로 갱신
2026-07-22 docs: README 기간·workflow 링크 추가, getting_started 전체 흐름·목차 추가
    - README Status에 수행 기간(2026-03~08) 명시, Documentation에 workflow 링크,
    Zynq-7020 칩 표기 병기
    - getting_started: 검증 루프/배포 루프 구조 요약 + 앵커 목차
2026-07-22 docs: Status 오늘 날짜로 최신화 + docs/workflow 안내문 추가
    - Status: 2026-07-22 기준, 남은 항목(공개 자산화·최종 발표 8/7) 명시
    - workflow/README.md: 계획(workflow)·기록(log) 역할 분리 규칙과 원본 보존 프레이밍
2026-07-22 docs: log/README 역할 분담 명시 + 개인정보 텍스트 마스킹
    - log/README: 검증 목표·PASS 기준·채택 결정·물리 실행 = 저자, 구현·정리 = AI
    협업 도구라는 분담을 명시, 본문의 '사용자' 지칭이 저자임을 안내
    - workflow_v24 전화번호, nitro help.md 서버 경로 내 학번 마스킹 (공개 준비)
2026-07-22 docs: 하위 README 현행화·톤 정리 + spec 현행화 주석
    - vivado/README: 일회성 스윕 런북을 sweep_loop_runbook.md로 분리, 폴더 안내로 교체
    - rtl/transposed_form/README: v2 파일 반영, 낡은 타이밍 수치를 sweep_summary 참조로
    - asic/oasys/README: 첫 줄 오탈자 제거, results 경로 구조를 실제(평면)와 일치,
    sweep_report 포인터. asic/nitro/README: P&R 중단 상태 노트
    - rtl_n43_transposed_spec: §0 현행화 주석 (v2 추가, 래퍼 2차 수정으로 §5/§7이
    수정 전 기준임을 명시, 타이밍 수치 출처 이관)
    - summary_design_decisions: §10 '이후 갱신' 표 추가 (v2·래퍼 수정·배포 주파수·
    ASI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
2026-07-22 docs: nitro help.md 정리 — 에러 원문만 error_records.md로 보존
    help 명령 덤프는 삭제, PLC1020/SDA101 원문은 중단 판단의 1차 증거로
    헤더(맥락 링크) 붙여 asic/nitro/로 이동
2026-07-22 docs: Nitro 중단의 툴 버그 판정 근거 서술 보강
    error_records.md에 판정 논거 4가지(assertion 성격, 파라미터 무관 재현,
    GEMM 대조군, 회피 수단 소진)와 중단 합리성 절 추가, sweep_report §6·
    nitro README에서 포인터 연결
2026-07-22 docs: 전수 검수 반영 — 루트 todo.md 이동, stale 행·유령 참조 정리
    - 루트 todo.md(2026-05 초기 계획 스냅샷) → docs/workflow/todo_2026-05_initial_plan.md
    이동, 대체 경위 헤더 추가
    - summary_design_decisions FFT x축 행: '개선 예정' → 구현 완료 반영(무효 영역 음영)
    - presentation_outline: 레포에 없는 읽을것.md 참조 제거
    - workflow_v24: LICENSE(MIT) 존재 확인 체크
2026-07-22 docs: CPU vs FPGA 벤치마크 수치 히스토리 기록 (162/83 → 221/85 정착)
    - log 49 신규: 수치 변천, 83→85 소견, FPGA 값 provenance 재확인 절차,
    보고서 반영 원칙(Ⅰ장=최종 수치, Ⅲ장=미팅 당시 수치+정정 부기)
    - 보고서 초안 2건의 3-2/4.3 수치를 최종값(221.0/85.0, 2.6배, 오차 3.8%)으로 갱신
    - Ubuntu 58.6µs는 별도 머신(Ryzen 7 9700X) 값임을 명시
    Claude-Session: https://claude.ai/code/session_016pe3kEkkoaTqk52ynCaYgN
2026-07-22 feat: 벤치마크 차트에 생성 시각 표기 + log 49 CPU 요동 관찰 기록
    - cpu_benchmark.py: 차트 우상단에 generated 시각 표기, 기본 파일명에
    타임스탬프 포함 (--chart-out 명시 시 기존 동작 유지)
    - log 49: 세션별 CPU median 요동(약 170~300µs) 관찰값 기록,
    FPGA 85µs 고정과 대비 — 보고서 확정값 221/85 픽스 명시
    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
2026-07-22 docs: 타임스탬프 벤치마크 차트 기록용 plot (보고서 확정값 221/85 plot은 유지)
2026-07-23 docs: 공개 전 전수조사 반영 — 확정 수치 정합·유령 참조 정리
    - 처리 시간 221.0/85.0µs(2.6배, 오차 3.8%) 최종 채택값으로 현재형 문서 통일
    (162/83은 세션 간 요동 중 당시 측정값 — 히스토리 부기만 유지)
    - 통과대역 0~15MHz·25MHz 실측 -60.3dB로 정정 (half-band 오기 → Kaiser lowpass)
    - sweep_loop_runbook에 Fmax 115→116 정정 경위 주석 (기록 원문 보존)
    - 삭제된 cpu_vs_fpga_timing_window.png 참조 → 실존 파일로 교체
    - repository_structure 현행화(v24), 절대경로 제거, spec 체크리스트 완료 처리
2026-07-23 build: 배포 산출물 정식 추적 — release/ BOOT.bin 승격 + 근거 rpt 3종
    - release/v2_145mhz(기본 권장)·v1_115mhz BOOT.bin git 추적 — 클론 직후 빌드 없이 보드 데모
    - sweep_summary_v2가 인용하는 v2_145mhz_*.rpt 3종 gitignore negation 후 추적
2026-07-23 docs: README 한/영 병기 개편 — 이미지·Requirements·License 추가
    - BD 다이어그램·scenario1_1 FFT·CPU 비교 차트 삽입 (한글 본문, 영어는 상단 그림 참조)
    - Requirements 섹션, 근거 링크 불릿화, Repository Map에 boards/·release/ 추가
    - Quick Start 보드 데모를 release/ BOOT.bin 기반으로 갱신, License(MIT) 섹션
2026-07-23 sim: 테스트 벡터 부재 시 자동 생성 — fresh clone 재현성 확보
    - run_all/run_legacy_n5가 벡터 없으면 골든모델 스크립트 자동 실행 (있으면 불변)
    - 검증: 벡터 전체 삭제 후 run_all/run_legacy_n5/run_bug 전부 PASS, 재생성 벡터 비트 동일
2026-07-23 docs: log 50 전수조사 기록 + workflow_v24 후속 체크리스트 갱신
2026-08-06 docs: 장학·제출 서류 레포에서 제외 — public 전환 준비
    - 활동계획서 pdf / 결과보고서 hwp: 장학 제출물이라 레포 성격과 무관
    - 보고서 초안 md 2종·발표 구성안: 근거 수치는 summary/ 4종에 모두 존재
    - git 히스토리 퍼지는 하지 않음 (민감도 낮음 — 2026-07-23 판단 유지)
2026-08-06 docs: 공개 자산화 마무리 — Velog 연재 링크 + 워크플로우·CLAUDE.md 현행화
    - README 한/영에 "개발 연재 (Velog)" 섹션 신설, 5편 전부 링크
    - README Status: 기술 포스팅 5편 완료 반영, 남은 것은 데모 영상·최종 발표
    - log 48 §4: 5차 미팅(7/29) 결과 기록 — 추가 지시 없음, v1↔v2는 v2로 확정
    - workflow_v24: §1~§5 완료 처리, §4 repo public 전환, §6 YouTube는 발표 후로 연기,
    §5에 연재 재구성 사유와 작성 중 확인된 사항 4건 기록, "현재 상태" 표 추가
    - CLAUDE.md: 기술 작업 종료 이후 단계(제출·발표·공개) 현황으로 갱신
2026-08-16 docs: 프로젝트 완결 처리 — 발표 완료 반영 + YouTube 영상 취소 확정
    8/7 최종 발표 수행 완료. YouTube 데모 영상은 "발표 후로 연기"에서
    "제작하지 않음"으로 확정(라이브 데모 + 백업 캡처본·레포 리포트로 시연 근거가
    이미 성립). 공개 자산은 GitHub·Velog 2종으로 확정.
    - workflow_v24: §6 취소 사유 명시(계획은 취소선으로 보존), §7 전 항목 완료,
    §8 종료 처리, 현재 상태 표·타임라인 현행화
    - CLAUDE.md: 완결 표시, 영상 관련 작업 재제안 금지 명시
    - README 한/영 Status: "데모 영상·발표 남겨둔 상태" → 완료
    미결은 기한 없는 선택 항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
2026-08-16 docs: 종료 처리 마무리 — v1.0 tag, 발표 피드백 log 미생성 확정
    발표는 질의응답·피드백 없이 발표만 진행돼 기록할 내용이 없었다. log 51을
    새로 만들지 않고 workflow_v24 §8 항목으로 해소한다 (log 50이 마지막).
    §8 미결 항목이 사라져 현재 상태 표를 완결로 정리.
    Claude-Session: https://claude.ai/code/session_01Y83ryLrZWRZDqiso7RDpbe
2026-08-16 docs: v1.0 tag 취소 — 태그 없이 종료, 잔여 미결 항목 명시
    git tag는 달지 않기로 확정(§8·CLAUDE.md 반영). 종료 요약에서 "미결 없음"
    단정을 정정해, §4의 axis TB `$readmemh` 경고가 미처리로 남아 있음과 그
    영향 범위(판정 무해)를 명시한다.
    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
